nakujaproject/N-4_Solid_Propulsion/Grains/README.md

# Propellant Evaluation

## Overview
This directory shall contain all matters to do with the analysis, synthesis and improvement of the Grains.
