nakujaproject/N-4_Solid_Propulsion/Grains/Decatalysis/README.md

# Analysis of Burn Rate Modifiers on Propellant

## Overview

This directory contains the write up for the analysis of the Propellant used in the Static Test conducted on Friday, 31 January, 2025.
