nakujaproject/N-4_Solid_Propulsion/SRM Components/Design Calculations.pdf

CASING DESIGN

The casing houses the grains and has a bulkhead on the forward end and a nozzle on the rear. Combustion happens inside the casing and it is necessary to ensure it can withstand the high temperatures and pressures. Aluminium 6063 T5 was selected for the casing material as it has a higher strength-to-weight ratio than steel and is also available in tubular form from local vendors.

The wall thickness was designed based on the maximum expected operating pressure
(MEOP) Pc, of 5 MPa based on past data.

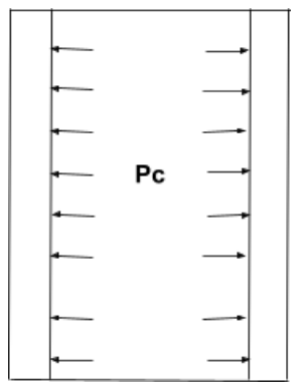
[picture p1: figure]

Figure 1: Casing design considerations
Problem Specifications | Al 6063 T5 Mechanical Properties
Specification | Value | Property | Value
Length, L Inner Diameter, d MEOP, Pc Minimum Sf | 725 mm
| 94 mm
| 4.26 MPa
| 2

σyp

σUTS

E

μ

110 MPa

150 MPa

70,000 MPa

0.33

Minimum thickness
Considering the hoop stress,

t =

Pc ∗ d ∗ Sf

2σyp

=

4.26 ∗ 94 ∗ 1.5
2 ∗ 110 = 2.7303 mm

A thickness of 3 mm is selected to cater for tolerances during manufacturing.

Expected change in length

∆l =

pc ∗ d ∗ l
4 ∗ t ∗ E

(1 − 2θ) =

5 ∗ 94 ∗ 725 4 ∗ 3 ∗ 70000 | (1 − 2 ∗ 0.33) = 0.1379 mm

Expected Change in diameter

∆d =

pc ∗ d

2
4 ∗ t ∗ E

(1 − θ) =

5 ∗ 94²
4 ∗ 3 ∗ 70000

(1 − 0.33) = 0.03524 mm

Burst Pressure

PB =

2 ∗ t ∗ σUTS
d

=

2 ∗ 3 ∗ 150
94 = 9.5745 MPa

NOZZLE DESIGN
Introduction
A de-Laval conical nozzle designed for the Nakuja N4 rocket was simulated in Ansys Fluent Software, and the throat and exit characteristics of the flow were determined. The nozzle accelerates the products of combustion, trading pressure for velocity to maximize the thrust generated.
Considerations for the expansion ratio, έ is the ratio of the nozzle exit area, Ae to that of the nozzle throat area, At.
Nozzle Design
The operating chamber pressure and Specific impulse were determined first using Open Motor,

Pc = 4. 26 MPa
Isp = 134. 83 s
Mass Flowrate,

ṁ =

I
Isp ∗ g

=

2431.36
134.22 ∗ 9.81 = 1. 8466 kg/s

Optimum throat area for sonic transition,

At =

ṁ

Pc ∗ √
R ∗ Tc
γ

∗ (1 +

γ − 1
2

)

γ+1
2γ−1

The specific gas constant of the combustion mixture is determined by,

R =

Ro
M

where M is the molecular weight = 35.361 g/mol (from Proprep)

Ro is the universal gas constant = 8.314 J/mol.

R =

8.314
35.361 ∗ 10⁻³ = 235. 1178

J
Kg.K

Chamber static temperature during combustion,

T c = 1595 K
Ratio of specific heats, γ = 1. 1369 (from Proprep)

Optimum throat diameter,

At =

1.8466
4.26 ∗ 10⁶

√
235.1178 ∗ 1595
1.1369 ∗ (1 +

1.1369 − 1
2

)

1.1369+1
2 (1.1369−1)
= 4. 17883 ∗ 10⁻⁴ m²

Throat diameter,

d = √
4 ∗ 4.17883 ∗ 10⁻⁴
π

= 23. 1 mm

Optimum throat-to-exit area ratio,

At
Ae

= (

γ + 1
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
∗ √(
γ + 1
γ − 1

) ∗ [1 − (
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
1.1369 + 1
2

)

1
1.1369−1
∗ (

101325
4.26 ∗ 10⁶

)

1
1.1369

∗ √(
1.1369 + 1
1.1369 − 1

) ∗ [1 − (
101325
4.26 ∗ 10⁶

)

1.1369−1
1.1369 ]

= 0. 14395

Optimum expansion ratio,

εopt = (

At
Ae

)

−1
= 0. 14395⁻¹ = 6. 947

Exit diameter,

De = √ε ∗ d = √6. 947 ∗ 23. 1 = 60. 9 mm ≅ 61 mm

BOLT DESIGN
a). BOLT SHEAR STRESS
This is the failure mode that occurs when the bolts used to hold the closure into the casing break due to the force applied perpendicular to the axis of the fastener. It is most likely to occur in designs with few fasteners of relatively small diameter, and is the only failure mode not affected by casing wall thickness.

Number of Bolts Calculation
Given Data:
- Maximum yield stress of mild steel: 250MPa
- Safety factor: 2
- Shear stress according to von Mises criterion is 60% of yield stress = 150MPa
- Diameter of M6 bolt: 6mm
- Chamber pressure (Pmax ):4. 26MPa
- Cross-sectional area of casing calculated based on inner diameter 94 mm
- Airframe weight: 22.5 Kg

Maximum Allowable Shear Stress,

τ max =

150MPa
2

= 75MPa

Shear stress on one bolt,

Area of M8 bolt =

π
4

∗ 8

2 = 50.2655 mm²

Force per bolt = τmax ∗ Area ∗ 2 = 75MPa ∗ 50.2655 ∗ 2 = 7539.82 N

Total Force Calculation
Force due to chamber pressure,

Fcℎamber = Pmax ∗ Cross − sectional Area = 4.26MPa ∗

π
4

∗ 94² = 29563.46 N

Force due to airframe resistance,

Fairframe = Weigℎt of airframe ∗ g = 22.5 kg ∗ 9.81 = 220.725 N
Total force,

Ftotal = Fcℎamber + Fairframe = 29563.46 + 220.725 = 29784.19 N
Number of bolts required,

Number of bolts =

Ftotal
Force per bolt =

29784.19
7539.82 = 3.95 ≈ 4 bolts

b). BOLT TEAR-OUT STRESS
Bolt tear-out is the failure in which the bolts tear through the aluminum motor casing. It is most likely to occur in designs where the fastener holes are very close to the edge of the casing, or the casing wall is relatively thin. This type of failure results from shear stresses in the
aluminum casing wall.

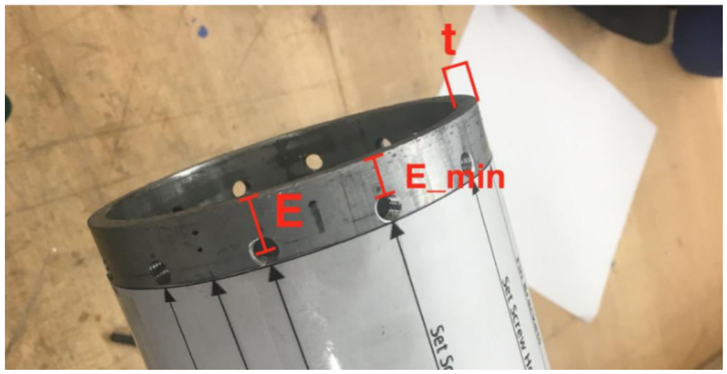
[picture p2: figure]

Note that E >= 2d (bolt major diameter) is highly recommended. And so E >= 2*8 mm = 16 mm

E(min) = E −

d(bolt,major)
2

= 16 −

8
2

= 12 mm

σtearout =

Fbolt
Emin ∗ 2t

=

7539.82
12 ∗ 2 ∗ 3

= 104.72 MPa

Shear strength is given as 115Mpa for aluminium 6063-T5.

c). BEARING STRESS
Bearing failure occurs when the force of the bolts pushing against the edges of their holes causes the casing material to fail in compression.
Bearing yield strength is given as 276MPa (not true value) for Aluminium 6063-T5.

σbearing =

Fbolt

dbolt major ∗ t

=

7539.82
8 ∗ 3

= 314.159 MPa

Using a safety factor of 1.5, maximum allowable bearing pressure = 184MPa

σbearing =

Fbolt

dbolt major ∗ t

=> Fbolt = 184 ∗ 8 ∗ 3 = 4416 N

Number of bolts =

Ftotal
Force per bolt =

29784.19 N
4416 N

= 6.745 ≅ 7 bolts.

To prevent bearing failure, 8 bolts are selected to ensure symmetry.

d). CASING TENSILE FAILURE
Casing tensile failure occurs when portions of the aluminium casing between the fastener holes are stretched beyond its breaking point.

σtensile =

Fdue to cℎamber pressure

[(Douter casing − t)π − N ∗ dbolt major] ∗ t

=

29563.46 N
[(100 − 3) ∗ π − 8 ∗ 8] ∗ 3

= 40.935 MPa
Aluminum 6063-T5 has a yield strength of at least 110 MPa
