nakujaproject/N-4_Solid_Propulsion/Ignition System/Alarm system module/3D view.png

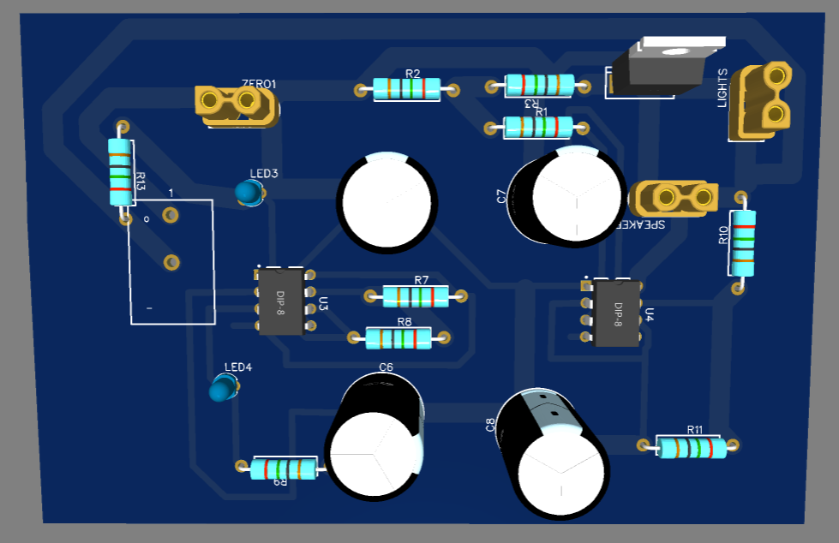
Ignition System/Alarm system module/3D view.png
