nakujaproject/N-4_Solid_Propulsion/Ignition System/Igniter circuit module/3D view.png

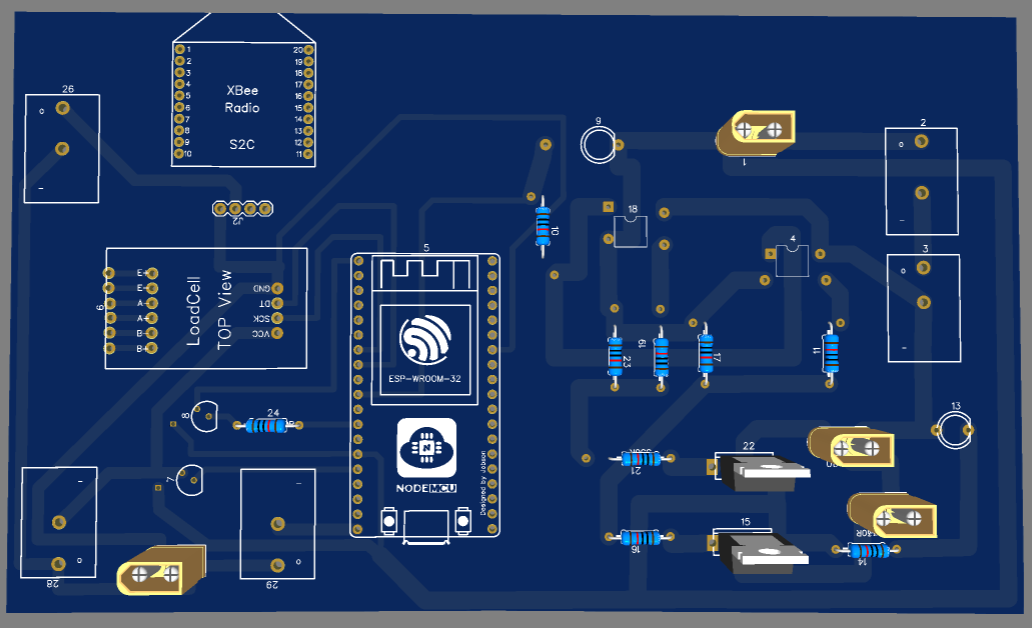
Ignition System/Igniter circuit module/3D view.png
