nakujaproject/N-4_Solid_Propulsion/Ignition System/Power Distribution Board module/3D view.png

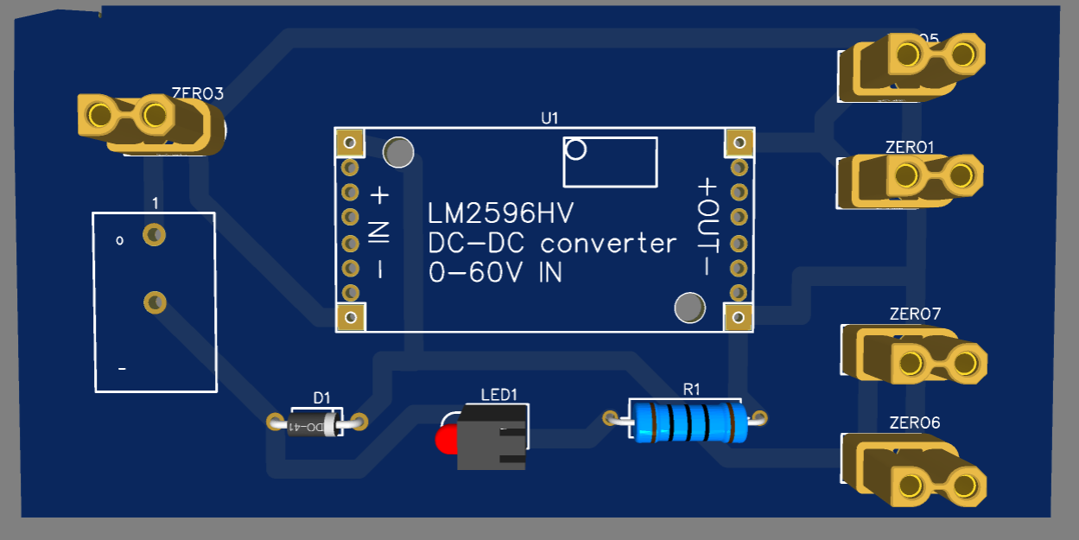
Ignition System/Power Distribution Board module/3D view.png
