nakujaproject/N-4_Solid_Propulsion/Ignition System/Trigger Module/3D view.png

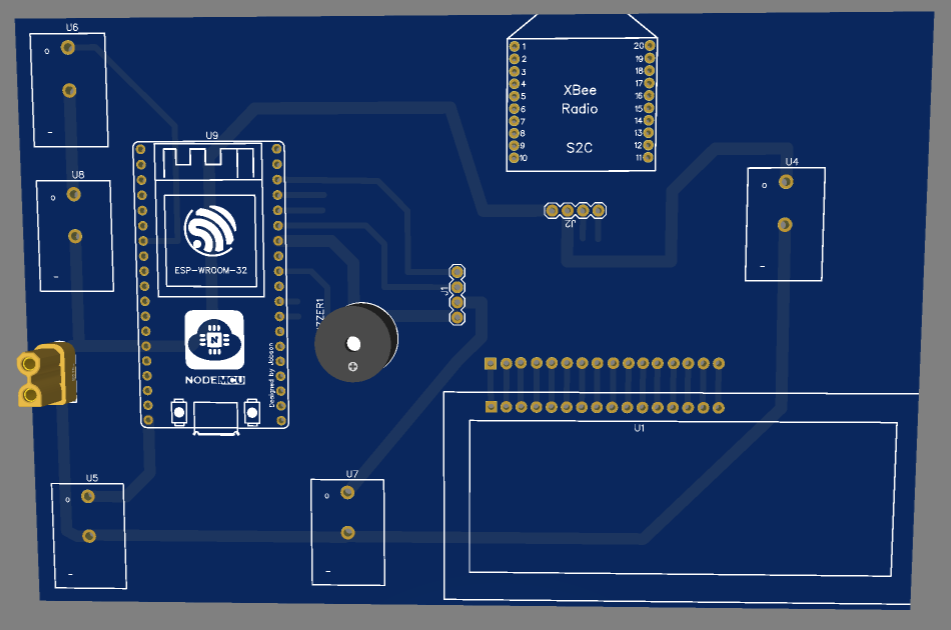
Ignition System/Trigger Module/3D view.png
