nakujaproject/N-4_Solid_Propulsion/SRM Components/README.md

# Solid Rocket Motor(SRM) Components

## Overview

This directory contains the design files and other necessary write ups for the SRM Components.
