nakujaproject/N-4_Solid_Propulsion/Static Test/Test #4/3_grain_Motor.SLDASM

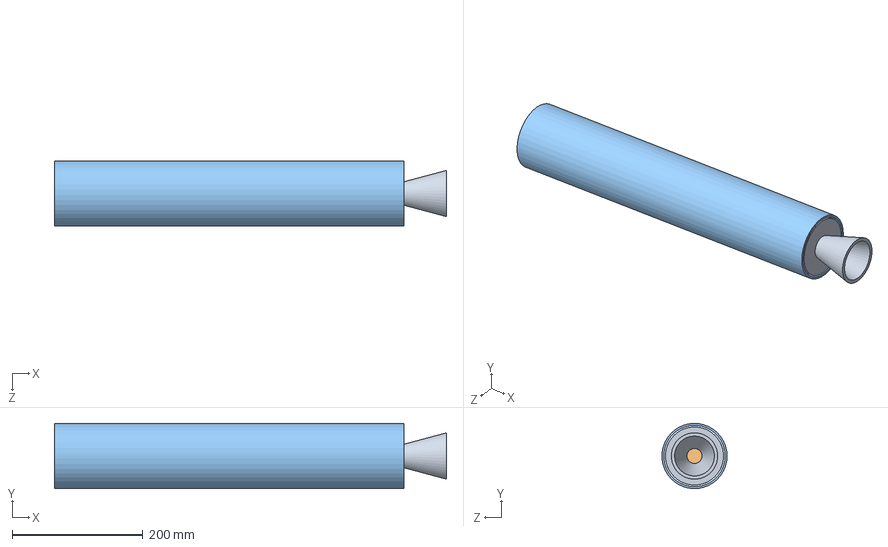
[picture p8: CAD file, 2025-02-07]
Static Test/Test #4/3_grain_Motor.SLDASM
600.2 x 99.9 x 100.0 mm
3_grain_Casing
Bulkhead
Nozzle2
