nakujaproject/N-4_Solid_Propulsion/Static Test/Test #1/Motor_Assembly_Test#1.SLDASM

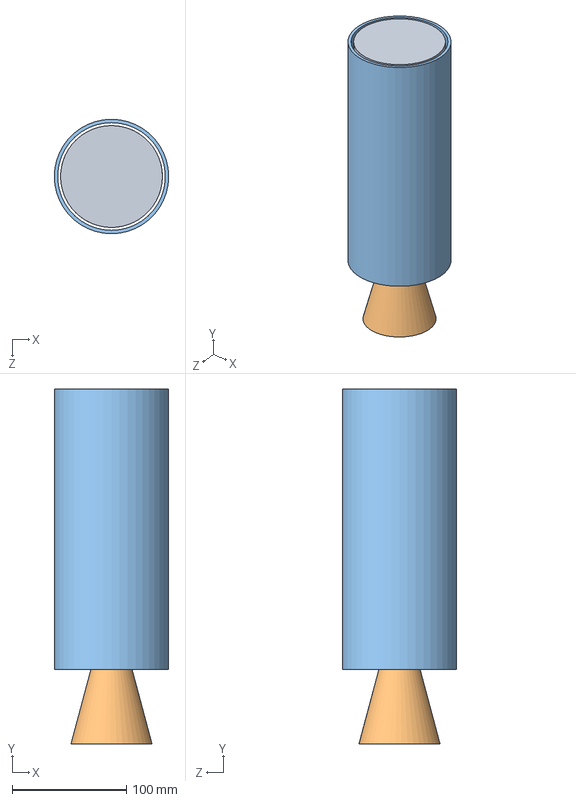
[picture p9: CAD file, 2025-02-07]
Static Test/Test #1/Motor_Assembly_Test#1.SLDASM
100.0 x 310.2 x 100.0 mm
Casing_Test#1
Nozzle2
Bulkhead
