nakujaproject/N-4_Solid_Propulsion/SRM Components/Assem1.SLDASM

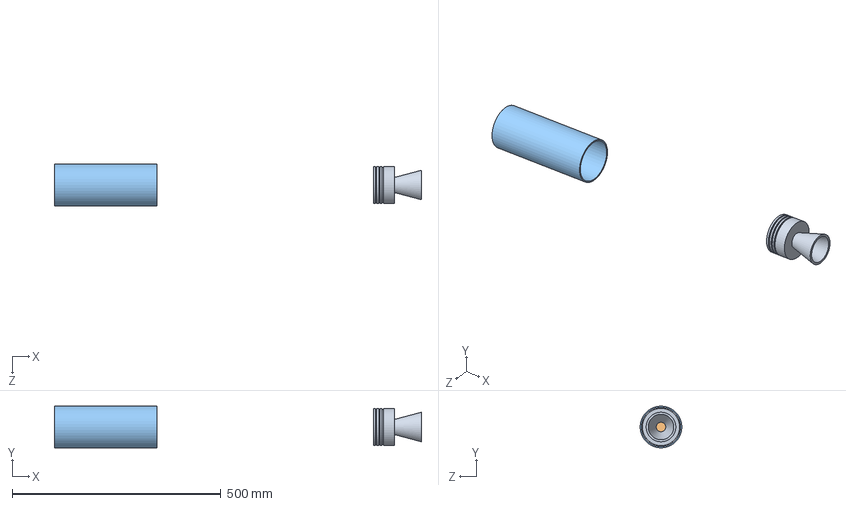
[picture p10: CAD file, 2025-02-07]
SRM Components/Assem1.SLDASM
878.8 x 100.0 x 100.0 mm
Casing
Bulkhead
Nozzle2
