nakujaproject/N-4_Solid_Propulsion/SRM Components/BodyTubeJig 1X15mm.SLDPRT

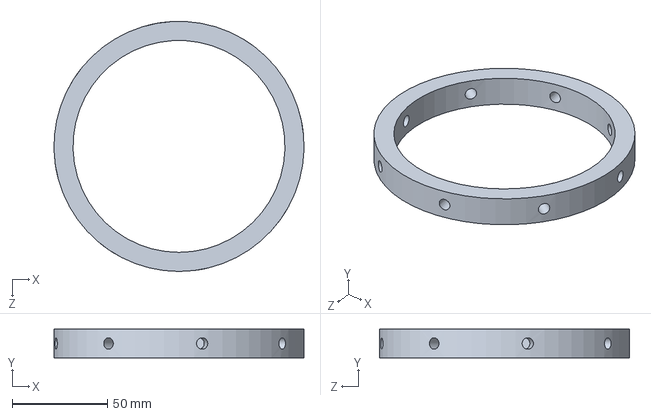
[picture p11: CAD file, 2025-02-07]
SRM Components/BodyTubeJig 1X15mm.SLDPRT
130.9 x 15.0 x 130.9 mm
