nakujaproject/N-4_Solid_Propulsion/Static Test/Test #1/Casing_Test#1.SLDPRT

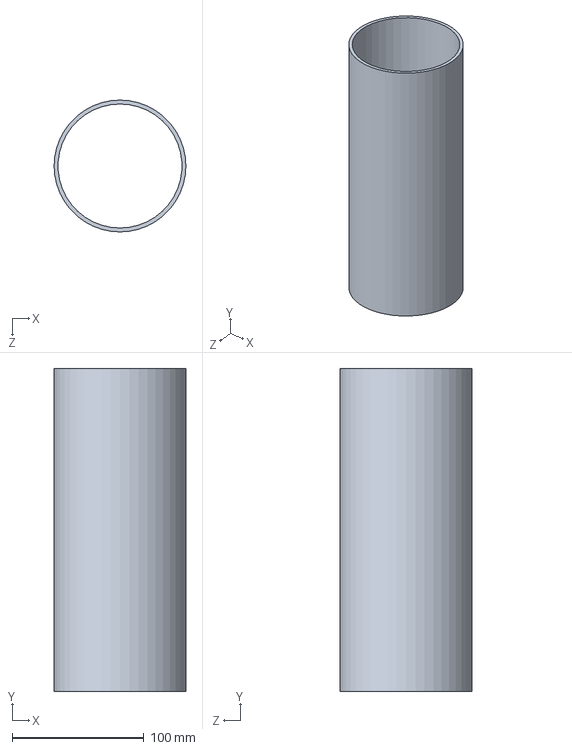
[picture p12: CAD file, 2025-02-07]
Static Test/Test #1/Casing_Test#1.SLDPRT
100.0 x 245.0 x 100.0 mm
