nakujaproject/N-4_Solid_Propulsion/Test Stand/TestStand_Design#2.STEP

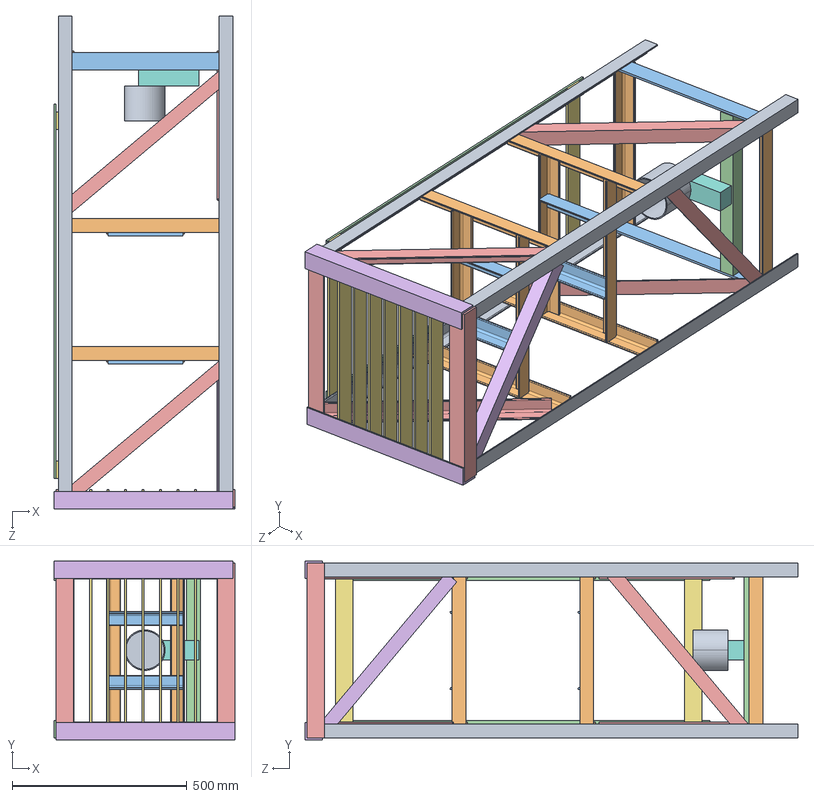
[picture p13: CAD file, 2025-02-07]
Test Stand/TestStand_Design#2.STEP
518.0 x 512.0 x 1412.0 mm
equal angle (new zealand) as-nzs_AS-NZS 3679.1 EAN - 40x40x5x1400 x 4
equal angle (new zealand) as-nzs_AS-NZS 3679.1 EAN - 40x40x5x490 x 6
bottom_flat-50x6x476 x 2
equal angle (new zealand) as-nzs_AS-NZS 3679.1 EAN - 40x40x5x476
equal angle (new zealand) as-nzs_AS-NZS 3679.1 EAN - 50x50x6x500 x 2
equal angle (new zealand) as-nzs_AS-NZS 3679.1 EAN - 50x50x6x512 x 2
top_flat-50x6x500 x 7
LoadCell
Motor Holder
equal angle (new zealand) as-nzs_AS-NZS 3679.1 EAN - 40x40x5x480 x 4
equal angle (new zealand) as-nzs_AS-NZS 3679.1 EAN - 40x40x5x214 x 4
Door_straight-50x6x1073^TestStand_Design#2 x 2
Door_horizontal-50x6x500^TestStand_Design#2 x 2
equal angle (new zealand) as-nzs_AS-NZS 3679.1 EAN - 40x40x5x598 x 5
equal angle (new zealand) as-nzs_AS-NZS 3679.1 EAN - 40x40x5x580
