nakujaproject/N-4_Solid_Propulsion/Static Test/Test #1/Nozzle2.SLDPRT

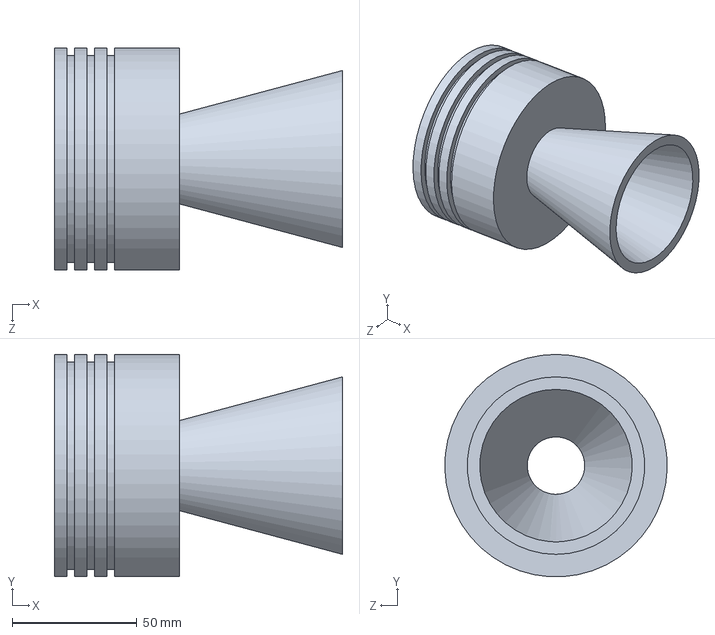
[picture p14: CAD file, 2025-02-07]
Static Test/Test #1/Nozzle2.SLDPRT
115.2 x 88.9 x 88.9 mm
