nakujaproject/N-4_Solid_Propulsion/Static Test/Test #4/Bulkhead.SLDPRT

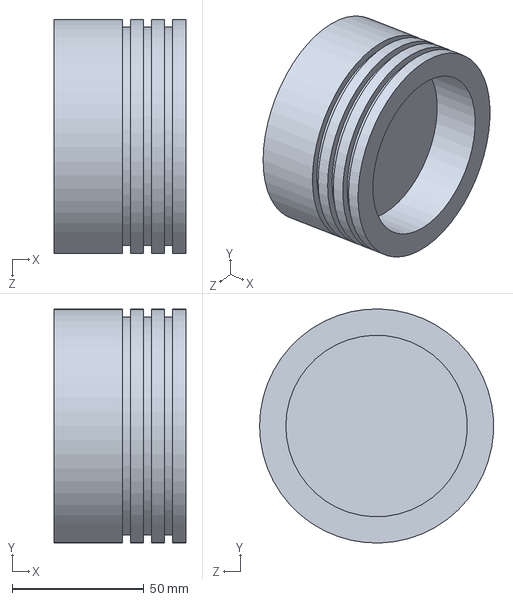
[picture p15: CAD file, 2025-02-07]
Static Test/Test #4/Bulkhead.SLDPRT
50.0 x 89.0 x 88.9 mm
