nakujaproject/N-4_Solid_Propulsion/SRM Components/Bulkhead.SLDPRT

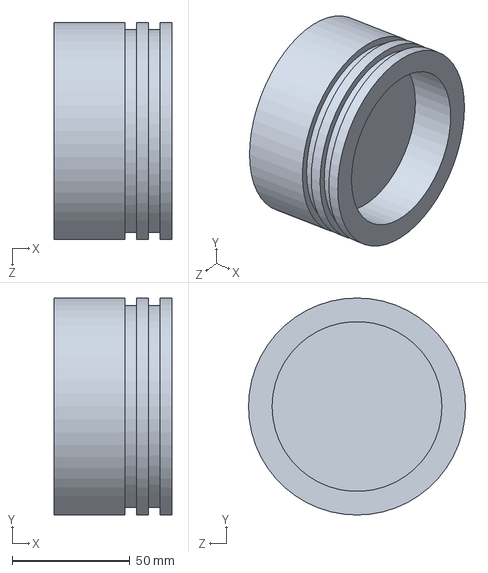
[picture p16: CAD file, 2025-02-07]
SRM Components/Bulkhead.SLDPRT
50.0 x 92.0 x 92.0 mm
