nakujaproject/N-4_Solid_Propulsion/Static Test/Test #4/3_grain_Casing.SLDPRT

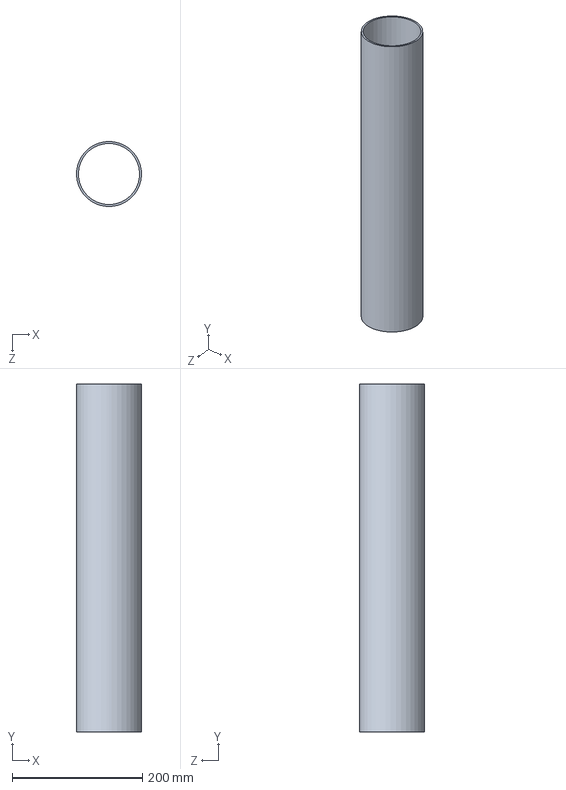
[picture p17: CAD file, 2025-02-07]
Static Test/Test #4/3_grain_Casing.SLDPRT
99.9 x 535.0 x 100.0 mm
