nakujaproject/N-4_Solid_Propulsion/SRM Components/Nozzle2.SLDPRT

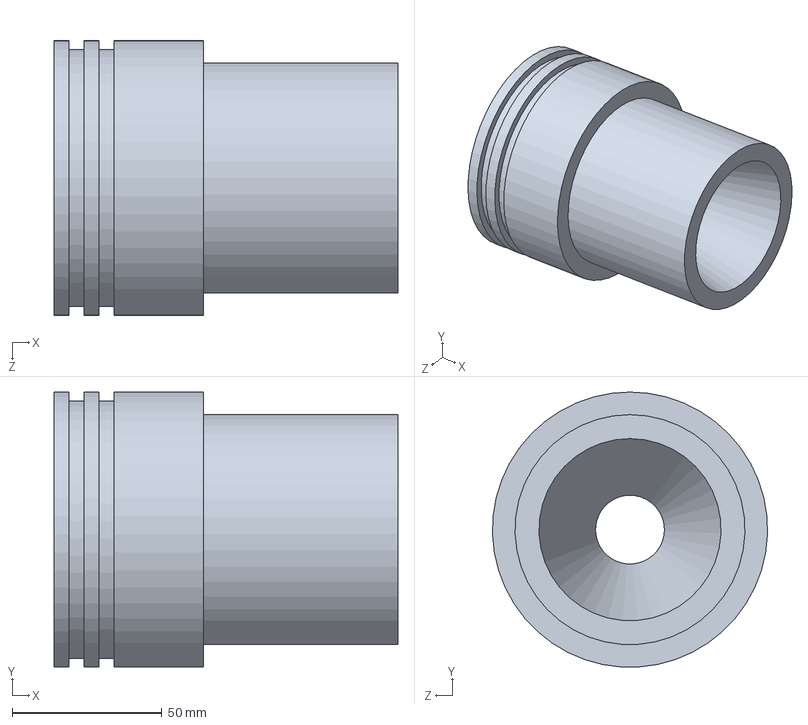
[picture p18: CAD file, 2025-02-07]
SRM Components/Nozzle2.SLDPRT
115.0 x 91.9 x 91.9 mm
