nakujaproject/N-4_Solid_Propulsion/(list of files, cad)

Other CAD files:
SRM Components/Casing.SLDPRT
Static Test/Test #1/Bulkhead.SLDPRT
Static Test/Test #4/Nozzle2.SLDPRT
SRM Components/Bulkhead_Drawing.SLDDRW
SRM Components/Casing_drawings.SLDDRW
SRM Components/Nozzle2_Drawing.SLDDRW
Test Stand/TestStand_Design#2.SLDASM
