nakujaproject/N-4_Solid_Propulsion/Static Test/Test #5/static test jan.txt

Broadcast message success
button is pressedLast Packet Sent to: ff:ff:ff:ff:ff:ff
Last Packet Send Status: Delivery Success
441746, 39.46,26.75,0.00
442293, -28.94,26.75,0.00
442840, 213048.92,26.75,0.00
443387, 325880.91,26.75,0.00
443934, -6221.68,26.75,0.00
