nakujaproject/N-4_Solid_Propulsion/Static Test/Test #4/Static test 31st Oct 2024 (reducted).txt

Broadcast message success
button is pressedLast Packet Sent to: ff:ff:ff:ff:ff:ff
Last Packet Send Status: Delivery Success
16251, 213.08
16261, 213.78
16272, 212.21
16282, 210.80
16293, 211.33
16304, 211.15
16315, 210.28
16325, 209.58
16336, 208.35
16347, 206.24
16357, 207.12
16368, 208.00
16379, 207.12
16389, 206.94
16400, 208.52
16411, 210.28
16422, 211.86
16432, 211.33
16443, 208.87
16454, 208.87
16464, 210.80
16475, 212.91
16486, 210.98
16496, 210.10
16507, 211.86
16518, 213.96
16529, 212.38
16539, 212.56
16550, 212.03
16561, 211.86
16571, 212.91
16582, 214.84
16593, 216.06
16603, 216.06
16614, 216.59
16625, 218.52
16635, 220.10
16646, 220.62
16657, 219.40
16668, 217.82
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
