nakujaproject/N-4_Solid_Propulsion/Static Test/Test #4/Static test 31st Oct 2024.txt

ets Jul 29 2019 12:21:46

rst:0x1 (POWERON_RESET),boot:0x13 (SPI_FAST_FLASH_BOOT)
configsip: 0, SPIWP:0xee
clk_drv:0x00,q_drv:0x00,d_drv:0x00,cs0_drv:0x00,hd_drv:0x00,wp_drv:0x00
mode:DIO, clock div:1
load:0x3fff0030,len:1448
load:0x40078000,len:14844
ho 0 tail 12 room 4
load:0x40080400,len:4
load:0x40080404,len:3356
entry 0x4008059c
ESP-NOW Broadcast Demo
MAC Address: 00:00:00:00:00:00
ESP-NOW Init Success
116, 227.11
127, 230.09
137, 229.39
148, 228.69
159, 229.04
169, 229.92
180, 232.55
191, 231.50
201, 228.69
212, 225.89
223, 224.48
234, 223.08
244, 222.55
255, 220.80
266, 219.57
276, 218.87
287, 217.29
298, 216.94
308, 214.49
319, 211.33
330, 211.15
340, 212.21
351, 211.50
362, 210.63
373, 208.52
383, 208.52
394, 208.87
405, 210.28
415, 211.86
426, 214.31
437, 215.54
447, 215.19
458, 215.19
469, 215.89
479, 215.89
490, 215.71
501, 217.64
512, 219.57
522, 220.27
533, 219.92
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
ets Jul 29 2019 12:21:46

rst:0x8 (TG1WDT_SYS_RESET),boot:0x13 (SPI_FAST_FLASH_BOOT)
configsip: 0, SPIWP:0xee
clk_drv:0x00,q_drv:0x00,d_drv:0x00,cs0_drv:0x00,hd_drv:0x00,wp_drv:0x00
mode:DIO, clock div:1
load:0x3fff0030,len:1448
load:0x40078000,len:14844
ho 0 tail 12 room 4
load:0x40080400,len:4
load:0x40080404,len:3356
entry 0x4008059c
ESP-NOW Broadcast Demo
MAC Address: 00:00:00:00:00:00
ESP-NOW Init Success
117, 130.83
128, 131.71
139, 132.59
149, 131.71
160, 129.60
171, 128.03
181, 127.50
192, 127.32
203, 127.67
213, 127.32
224, 126.62
235, 125.75
245, 125.39
256, 125.57
267, 125.92
277, 125.39
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
16454, 208.87
16464, 210.80
16475, 212.91
16486, 210.98
16496, 210.10
16507, 211.86
16518, 213.96
16529, 212.38
16539, 212.56
16550, 212.03
16561, 211.86
16571, 212.91
16582, 214.84
16593, 216.06
16603, 216.06
16614, 216.59
16625, 218.52
16635, 220.10
16646, 220.62
16657, 219.40
16668, 217.82
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
