nakujaproject/N-4_Solid_Propulsion/Static Test/Test #1/Static Test #1.txt

; Nakuja Project Static Test #1
; Carried out on Friday 14th June 2024
; created by Ogweno Emmanuel 6/21.2024
N4_1 86 145 P 1.191 3.3 Nakuja 
0	0
0	10.08738213
0.011	10.52075346
0.022	10.96795266
0.032	11.45300688
0.043	11.94316074
0.054	12.43507986
0.064	12.93896352
0.075	13.53581754
0.086	14.08442112
0.097	14.70706755
0.107	15.40532595
0.129	16.9739556
0.139	17.87345364
0.15	18.92770614
0.161	19.94420169
0.177	20.94010254
0.182	21.9117801
0.193	23.10029043
0.204	24.47454534
0.214	25.51850049
0.225	26.70181311
0.236	28.08116766
0.246	29.47944972
0.257	30.87606459
0.268	32.30533677
0.28	33.8567061
0.289	35.40631017
0.3	36.87343737
0.311	38.72578353
0.321	40.64697483
0.332	42.57669822
0.343	44.52711438
0.353	46.68730227
0.364	48.91800249
0.375	50.95275885
0.385	52.90994184
0.396	54.93606804
0.407	57.7102722
0.418	60.38817162
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
