nakujaproject/N-4_Solid_Propulsion/Static Test/Test #4/Static test 25th april 2024 analysis..xlsx

Sheet: SIMULATED VS ACTUAL 25_04_2024
SIMULATED TIME | SIMULATED THRUST | ACTUAL TIME (ms) | ACTUAL TIME (s) | ACTUAL THRUST (gf) | ACTUAL THRUST (N) | IMPULSE
0 | 0 | 134956 | 0 | -14.91 | -0.1462671 | -0.0029286774
0.03 | 1113.17484 | 134979 | 0.023 | -11.05 | -0.1084005 | -0.0009938511
0.06 | 1140.93601 | 134990 | 0.034 | -7.37 | -0.0722997 | -0.0009938511
0.09 | 1168.54542 | 135023 | 0.067 | 1.23 | 0.0120663 | 0.09842063985
0.12 | 1195.95482 | 135192 | 0.236 | 117.5 | 1.152675 | 0.0284817654
0.15 | 1223.1147 | 135214 | 0.258 | 146.44 | 1.4365764 | 0.01583093655
0.18 | 1249.97442 | 135225 | 0.269 | 146.97 | 1.4417757 | 0.03456538785
0.21 | 1273.35386 | 135248 | 0.292 | 159.42 | 1.5639102 | 0.0174868155
0.24 | 1286.42713 | 135259 | 0.303 | 164.68 | 1.6155108 | 0.0357117354
0.27 | 1299.04592 | 135281 | 0.325 | 166.26 | 1.6310106 | 0.0196339302
0.3 | 1311.20843 | 135293 | 0.337 | 167.31 | 1.6413111 | 0.01828157265
0.33 | 1322.91293 | 135304 | 0.348 | 171.52 | 1.6826112 | 0.05876185095
0.36 | 1334.15776 | 135337 | 0.381 | 191.51 | 1.8787131 | 0.04993755975
0.39 | 1344.94134 | 135360 | 0.404 | 251.14 | 2.4636834 | 0.033354981
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
