nakujaproject/N-4_Solid_Propulsion/Static Test/Test #4/Static test on 31st Oct 2024 (Analysis).xlsx

Simulated Time (s) | Simulated Thrust (N) | Actual Time (ms) | Time Diff (ms) | Actual Time (s) | Actual Thrust (g) | Actual Thrust (N) | Actual Impulse (Ns)
0 | 0 | 29883 | 0 | 0 | 215.01 | 2.1092481 | 14.54356711
0.03 | 1173.3067 | 30247 | 364 | 0.364 | 7930.73 | 77.8004613 | 0.9038838353
0.06 | 1180.11471 | 30258 | 375 | 0.375 | 8821.82 | 86.5420542 | 0.91469421
0.09 | 1186.80055 | 30268 | 385 | 0.385 | 9826.38 | 96.3967878 | 1.121728766
0.12 | 1193.3643 | 30279 | 396 | 0.396 | 10963.7 | 107.553897 | 1.252528096
0.15 | 1199.806 | 30290 | 407 | 0.407 | 12250.61 | 120.1784841 | 2.828572923
0.18 | 1206.12571 | 30311 | 428 | 0.428 | 15209.93 | 149.2094133 | 1.732701158
0.21 | 1212.32349 | 30322 | 439 | 0.439 | 16903.89 | 165.8271609 | 1.748173883
0.24 | 1218.39939 | 30332 | 449 | 0.449 | 18736.76 | 183.8076156 | 12.73670834
0.27 | 1224.35346 | 30386 | 503 | 0.503 | 29349.88 | 287.9223228 | 3.290091191
0.3 | 1230.18575 | 30397 | 514 | 0.514 | 31628.55 | 310.2760755 | 117.5080245
0.33 | 1235.8963 | 30643 | 760 | 0.76 | 65756.75 | 645.0737175 | 6.491968115
0.36 | 1241.48517 | 30653 | 770 | 0.77 | 66597.34 | 653.3199054 | 7.237473522
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
