nakujaproject/N-4_Solid_Propulsion/Static Test/Test #3/static test 13th aug 2024.csv

Simulated Time(s) | Simulated Thrust(N) | Actual Time (ms) | Time diff (ms) | Actual Time (s) | Actual Thrust (g) | Actual Thrust (N) | Actual Impulse (Ns)
0 | 0 | 140264 | 0 | 0 | 690.11 | 6.7699791 | 0.0829952
0.03 | 1173.3067 | 140275 | 11 | 0.011 | 848.12 | 8.3200572 | 0.102279796
0.06 | 1180.11471 | 140286 | 22 | 0.022 | 1047.53 | 10.2762693 | 0.11445278
0.09 | 1186.80055 | 140296 | 32 | 0.032 | 1285.86 | 12.6142866 | 0.153982714
0.12 | 1193.3643 | 140307 | 43 | 0.043 | 1568.05 | 15.3825705 | 0.186921702
0.15 | 1199.806 | 140318 | 54 | 0.054 | 1896.35 | 18.6031935 | 0.225386222
0.18 | 1206.12571 | 140329 | 65 | 0.065 | 2280.95 | 22.3761195 | 0.270569757
0.21 | 1212.32349 | 140340 | 76 | 0.076 | 2733.78 | 26.8183818 | 0.294816006
0.24 | 1218.39939 | 140350 | 86 | 0.086 | 3276.74 | 32.1448194 | 0.388443627
0.27 | 1224.35346 | 140361 | 97 | 0.097 | 3922.66 | 38.4812946 | 0.465298208
0.3 | 1230.18575 | 140372 | 108 | 0.108 | 4701.16 | 46.1183796 | 0.558143972
0.33 | 1235.8963 | 140383 | 119 | 0.119 | 5643.46 | 55.3623426 | 0.609228468
0.36 | 1241.48517 | 140393 | 129 | 0.129 | 6777.1 | 66.483351 | 0.800553536
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
