nakujaproject/N-4_Solid_Propulsion/Static Test/Test #2/Test Data Analysis.xlsx

Sheet: Static test II 26-07-24
245056 | 0 | 2366.01
245067 | 11 | 2461.24
245079 | 23 | 2562.26
245090 | 34 | 2670.29
245101 | 45 | 2772.19
245112 | 56 | 2867.77
245123 | 67 | 2967.2
245134 | 78 | 3079.09
245145 | 89 | 3187.48
245156 | 100 | 3291.13
245167 | 111 | 3407.75
245178 | 122 | 3541.92
245189 | 133 | 3684.85
245200 | 144 | 3846.9
245211 | 155 | 4026.48
245222 | 166 | 4211.86
245233 | 177 | 4423.36
245244 | 188 | 4664.5
245255 | 199 | 4921.96
245266 | 210 | 5208.17
245277 | 221 | 5549.28
245288 | 232 | 5918.63
245299 | 243 | 6356.89
245310 | 254 | 6678.53
245321 | 265 | 6678.53
245332 | 276 | 6727.64
245344 | 288 | 7203.96
245355 | 299 | 8351.46
245366 | 310 | 10481.41
245377 | 321 | 11248.86
245388 | 332 | 11754.65
245399 | 343 | 12988.78
245410 | 354 | 14346.72
245421 | 365 | 15002.98
245432 | 376 | 15545.77
245443 | 387 | 16635.57
245454 | 398 | 17671.69
245465 | 409 | 18208.52
245476 | 420 | 18928.62
245487 | 431 | 19935.11
245498 | 442 | 20653.8
245509 | 453 | 21439.67
245520 | 464 | 22850.58
245531 | 475 | 23829.53
245542 | 486 | 24199.93
245553 | 497 | 23625.39
245564 | 508 | 23522.8
245575 | 519 | 24262.89
245586 | 530 | 25136.44
245597 | 541 | 25544.02
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
