nakujaproject/N-4_Solid_Propulsion/Static Test/Test #1/N4_1grain_simulated.csv

Time(s) | Thrust(N)
0 | 0
0.03 | 311.60302
0.06 | 314.06578
0.09 | 316.46953
0.12 | 318.81477
0.15 | 321.10201
0.18 | 323.33174
0.21 | 325.50442
0.24 | 327.62049
0.27 | 329.6804
0.3 | 331.68454
0.33 | 333.63334
0.36 | 335.52716
0.39 | 337.36638
0.42 | 339.15136
0.45 | 340.88244
0.48 | 342.55995
0.51 | 344.1842
0.54 | 345.7555
0.57 | 347.27415
0.6 | 348.74041
0.63 | 350.15455
0.66 | 351.51684
0.69 | 352.82752
0.72 | 354.08683
0.75 | 355.29498
0.78 | 356.45219
0.81 | 357.55867
0.84 | 358.6146
0.87 | 359.62018
0.9 | 360.57557
0.93 | 361.48094
0.96 | 362.33645
0.99 | 363.14224
1.02 | 363.89844
1.05 | 364.6052
1.08 | 365.26262
1.11 | 365.87082
1.14 | 366.4299
1.17 | 366.93996
1.2 | 367.40107
1.23 | 367.81333
1.26 | 368.17679
1.29 | 368.49152
1.32 | 368.75758
1.35 | 368.975
1.38 | 369.14382
1.41 | 369.26408
1.44 | 369.33579
1.47 | 369.35897
1.5 | 369.33362
1.53 | 369.25975
1.56 | 369.13733
1.59 | 368.96636
1.62 | 368.7468
1.65 | 368.47863
1.68 | 368.1618
1.71 | 367.79625
1.74 | 367.38194
1.77 | 366.9188
1.8 | 366.40674
1.83 | 365.8457
1.86 | 365.23557
1.89 | 364.57626
1.92 | 363.86767
1.95 | 363.10966
1.98 | 362.30213
2.01 | 361.44494
2.04 | 360.53794
2.07 | 359.58098
2.1 | 358.5739
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
