nakujaproject/N-4_Solid_Propulsion/Static Test/Test #1/StaticTest1.xlsx

Sheet: Raw Data
Initial Value | t(ms) |  | M [grams] | W into N | t(s)
75318 | 0 | 75318 | 1028.59 | 10.08738213 | 0
75318 | 11 | 75329 | 1072.78 | 10.52075346 | 0.011
75318 | 22 | 75340 | 1118.38 | 10.96795266 | 0.022
75318 | 32 | 75350 | 1167.84 | 11.45300688 | 0.032
75318 | 43 | 75361 | 1217.82 | 11.94316074 | 0.043
75318 | 54 | 75372 | 1267.98 | 12.43507986 | 0.054
75318 | 64 | 75382 | 1319.36 | 12.93896352 | 0.064
75318 | 75 | 75393 | 1380.22 | 13.53581754 | 0.075
75318 | 86 | 75404 | 1436.16 | 14.08442112 | 0.086
75318 | 97 | 75415 | 1499.65 | 14.70706755 | 0.097
75318 | 107 | 75425 | 1570.85 | 15.40532595 | 0.107
75318 | 129 | 75447 | 1730.8 | 16.9739556 | 0.129
75318 | 139 | 75457 | 1822.52 | 17.87345364 | 0.139
75318 | 150 | 75468 | 1930.02 | 18.92770614 | 0.15
75318 | 161 | 75479 | 2033.67 | 19.94420169 | 0.161
75318 | 177 | 75495 | 2135.22 | 20.94010254 | 0.177
75318 | 182 | 75500 | 2234.3 | 21.9117801 | 0.182
75318 | 193 | 75511 | 2355.49 | 23.10029043 | 0.193
75318 | 204 | 75522 | 2495.62 | 24.47454534 | 0.204
75318 | 214 | 75532 | 2602.07 | 25.51850049 | 0.214
75318 | 225 | 75543 | 2722.73 | 26.70181311 | 0.225
75318 | 236 | 75554 | 2863.38 | 28.08116766 | 0.236
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
