nakujaproject/N-4_Solid_Propulsion/Static Test/Test #4/Simulated.csv

Time(s) | Thrust(N)
0 | 0
0.03 | 1173.3067
0.06 | 1180.11471
0.09 | 1186.80055
0.12 | 1193.3643
0.15 | 1199.806
0.18 | 1206.12571
0.21 | 1212.32349
0.24 | 1218.39939
0.27 | 1224.35346
0.3 | 1230.18575
0.33 | 1235.8963
0.36 | 1241.48517
0.39 | 1246.9524
0.42 | 1252.29804
0.45 | 1257.52212
0.48 | 1262.6247
0.51 | 1267.6058
0.54 | 1272.46548
0.57 | 1277.20376
0.6 | 1281.82069
0.63 | 1286.31631
0.66 | 1290.69065
0.69 | 1294.94373
0.72 | 1299.07561
0.75 | 1303.0863
0.78 | 1306.97584
0.81 | 1310.74426
0.84 | 1314.39158
0.87 | 1317.91784
0.9 | 1321.32306
0.93 | 1324.60727
0.96 | 1327.77049
0.99 | 1330.81275
1.02 | 1333.73407
1.05 | 1336.53447
1.08 | 1339.21396
1.11 | 1341.77258
1.14 | 1344.21035
1.17 | 1346.52727
1.2 | 1348.72336
1.23 | 1350.79865
1.26 | 1352.75314
1.29 | 1354.58686
1.32 | 1356.29981
1.35 | 1357.89201
1.38 | 1359.36347
1.41 | 1360.7142
1.44 | 1361.94421
1.47 | 1363.05351
1.5 | 1364.0421
1.53 | 1364.91
1.56 | 1365.65721
1.59 | 1366.28374
1.62 | 1366.78959
1.65 | 1367.17477
1.68 | 1367.43927
1.71 | 1367.5831
1.74 | 1367.60627
1.77 | 1367.50877
1.8 | 1367.29059
1.83 | 1366.95175
1.86 | 1366.49224
1.89 | 1365.91205
1.92 | 1365.21118
1.95 | 1364.38962
1.98 | 1363.44738
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
