nakujaproject/N-4_Solid_Propulsion/Grains/Decatalysis/ProPEP Simulations/TestingKNSB_FeO3 Catalyst.JPG

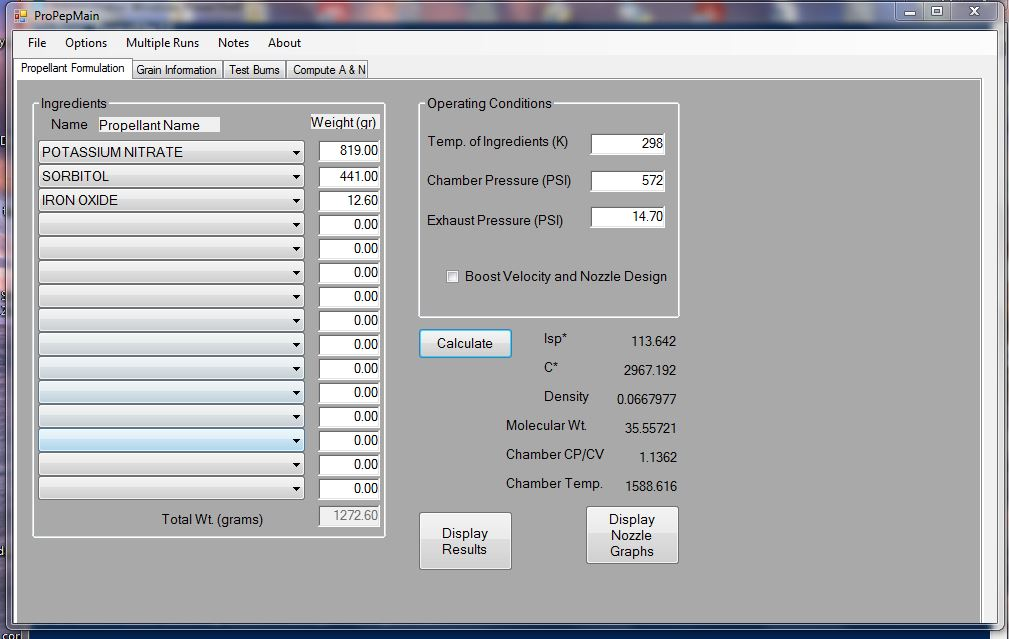
Grains/Decatalysis/ProPEP Simulations/TestingKNSB_FeO3 Catalyst.JPG
