nakujaproject/N-4_Solid_Propulsion/Grains/Decatalysis/ProPEP Simulations/TestingKNSB_OxFe Proposed.JPG

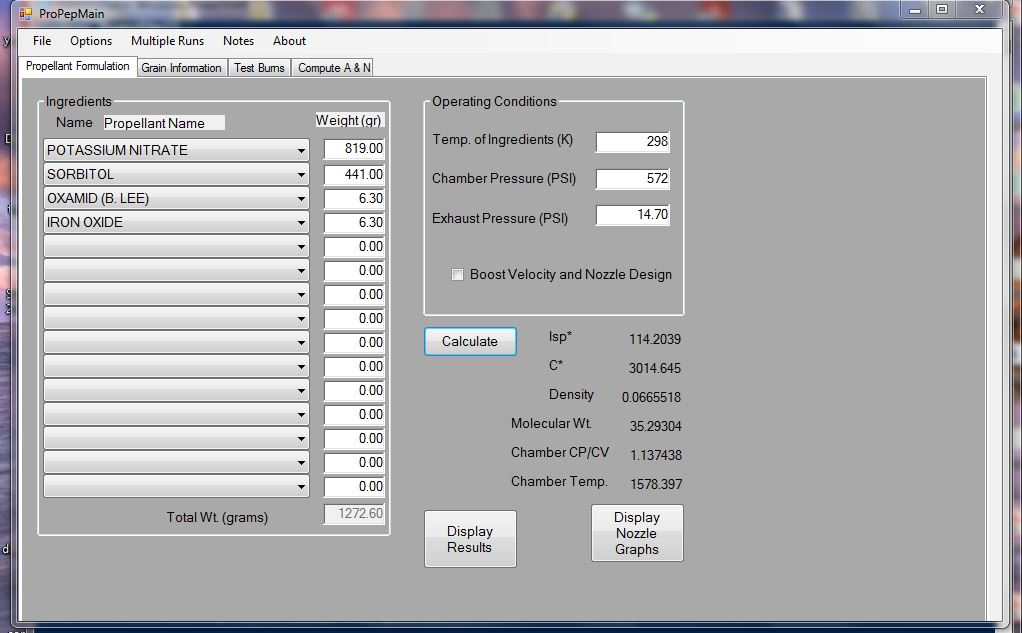
Grains/Decatalysis/ProPEP Simulations/TestingKNSB_OxFe Proposed.JPG
