nakujaproject/N-4_Solid_Propulsion/Static Test/Test #3/475f5efb-72d6-4bed-bb2a-de2ddac30baa.jpg

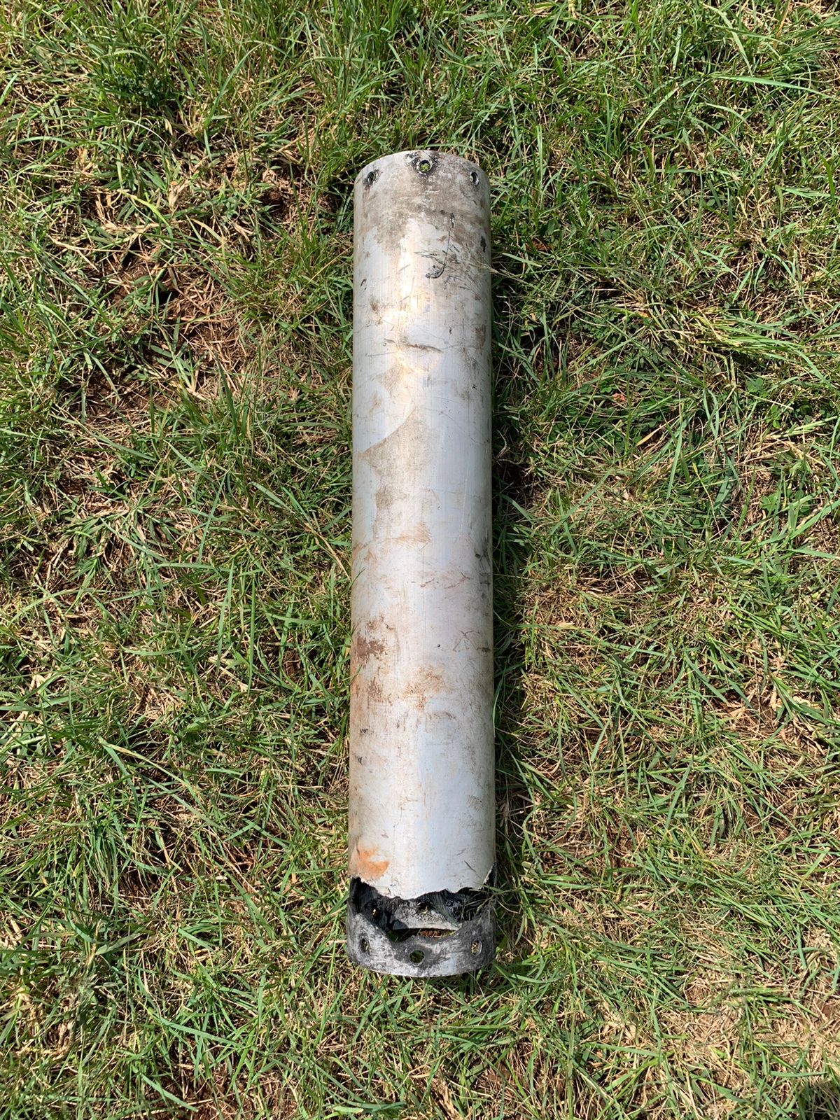
Static Test/Test #3/475f5efb-72d6-4bed-bb2a-de2ddac30baa.jpg
