nakujaproject/N-4_Solid_Propulsion/Static Test/Test #3/67685876-ea43-461c-90ff-0748b4c1349a.jpg

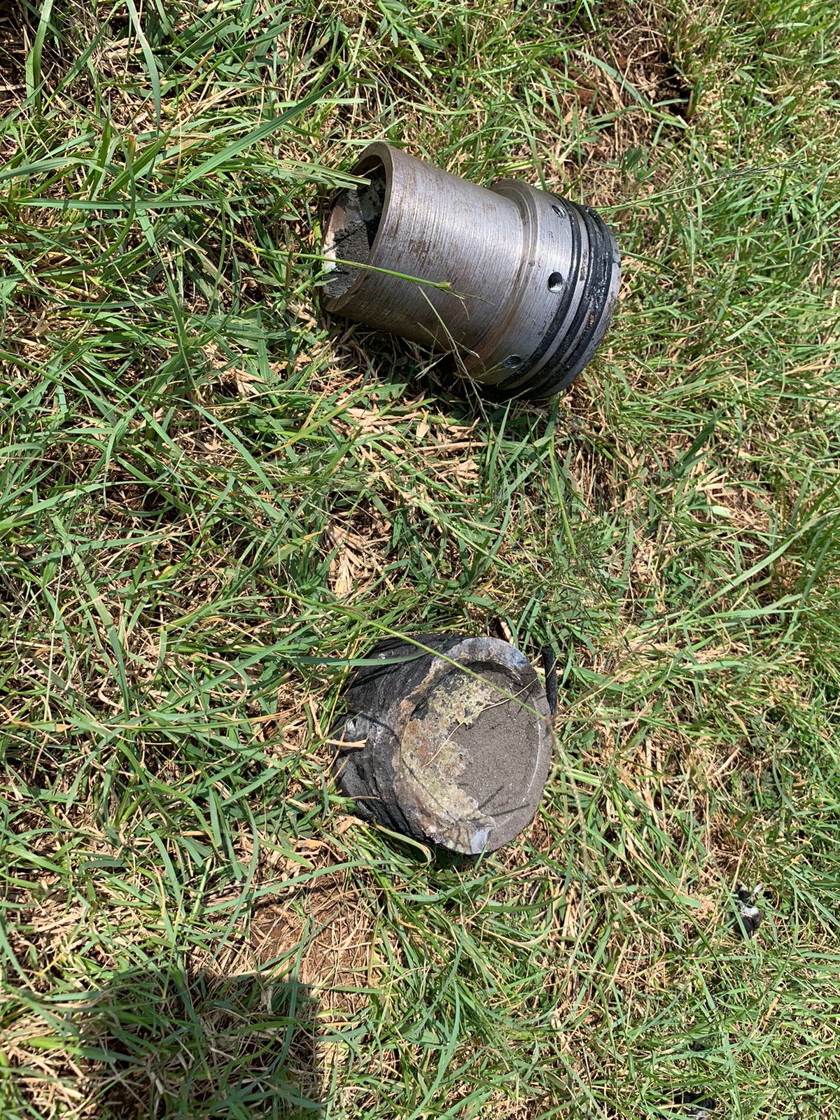
Static Test/Test #3/67685876-ea43-461c-90ff-0748b4c1349a.jpg
