nakujaproject/N-4_Solid_Propulsion/Static Test/Test #4/Screenshot 2024-10-31 212610.png

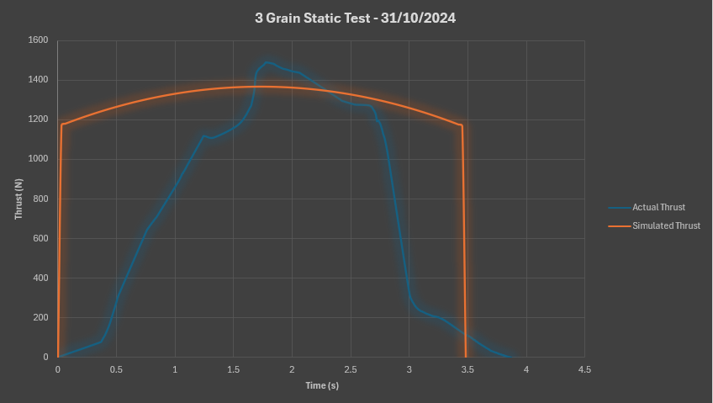
Static Test/Test #4/Screenshot 2024-10-31 212610.png
