nakujaproject/N-4_Solid_Propulsion/Static Test/Test #4/WhatsApp Image 2024-10-31 at 14.06.16.jpeg

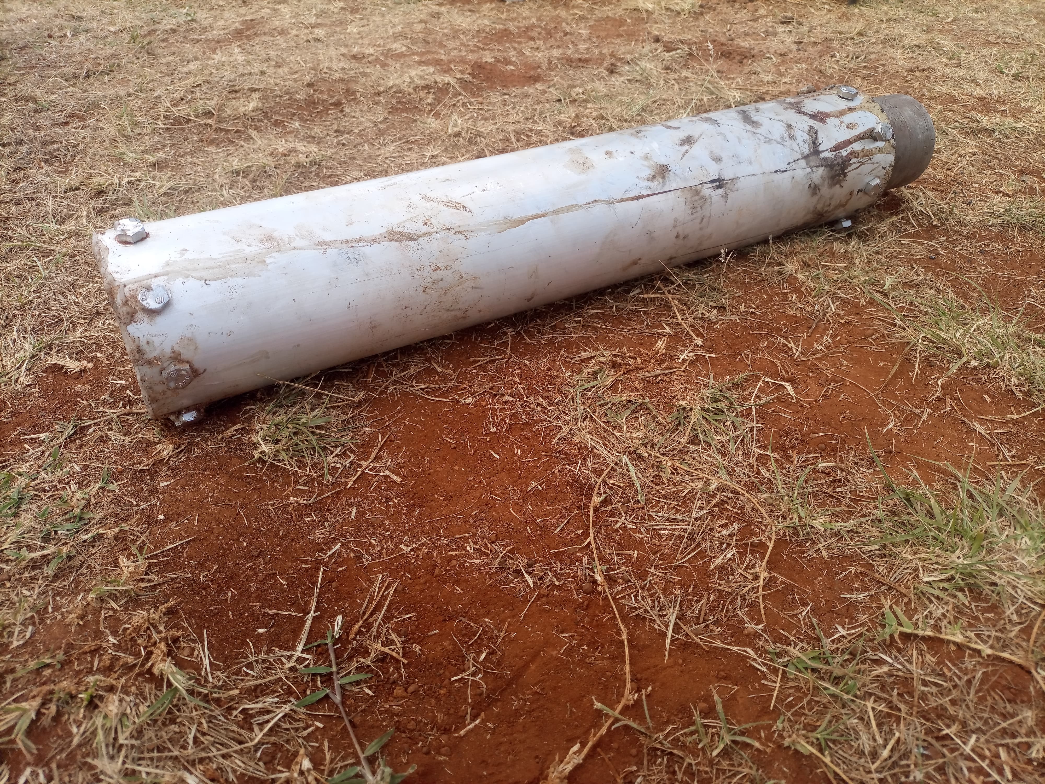
Static Test/Test #4/WhatsApp Image 2024-10-31 at 14.06.16.jpeg
