nakujaproject/N-4_Solid_Propulsion/(threads)

Thread 10 (2025-01-31):

Consideration of safer test stand site

shohei, 2025-01-31:

shohei, 2025-03-07:
- Visualize how to fix the stand to the ground
- Use soil hardner or cement?
- Cost estimation. Make a Bill Of Materials (BOM).
- Use of excavator. Does the farm have one?
- Confirmation of Location

NGGithua1, 2025-03-14:
updated design consideration
use of wooden beams, Ms plate t=1.5mm, Block boards (sw)
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

Closed 2025-03-14.

Thread 4 (2025-02-12):

Documentation of grain preparation

shohei, 2025-02-12:

Ogweno-lab, 2025-02-13:
[Static Test #5 Failure Analysis.pdf](https://github.com/user-attachments/files/18779976/Static.Test.5.Failure.Analysis.pdf)

azid0azide, 2025-02-19:
Here's the [link](https://github.com/nakujaproject/N-4_Solid_Propulsion/blob/main/Grains/Preparation/CookingKNSBTheRightWay.pdf) to the documentation.

azid0azide, 2025-02-19:
Here's the [link](https://github.com/nakujaproject/N-4_Solid_Propulsion/blob/main/Grains/Preparation/CookingKNSBTheRightWay.pdf) to the documentation. It should be noted that this isn't the final draft because of future optimization of the Grain Preparation Procedure.

Closed 2025-02-21.

Thread 8 (2025-02-21):

Preparation of the ignition circuit

shohei, 2025-02-21:
Repairing of the ignition circuit damaged at the last testing.

Thread 13 (2025-03-07):

Sorbitol mositure analysis

NGGithua1, 2025-03-07:
Test sample 1 results:
Initial moisture analysis shows a water content of 25.853%.

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

Test sample 2 in progress.

NGGithua1, 2025-03-14:
Test 2 results:

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

Test 3 results:

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

summary of results:
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

revised grain calculation, considering adjusted % of liquid sorbitol

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

[REVIEWED N4 GRAIN CALCULATION.docx](https://github.com/user-attachments/files/19245836/REVIEWED.N4.GRAIN.CALCULATION.docx)

shohei, 2025-03-14:
Could you talk to Mr. Matunda if we can have one more test? This is to confirm if the measurement for the sample #2 and #3 are more reliable.

azid0azide, 2025-03-14:
The following is the second draft of the report as we await the new single moisture content test: [link](https://github.com/nakujaproject/N-4_Solid_Propulsion/blob/main/Grains/Preparation/CookingKNSBTheRightWay.pdf)

Ogweno-lab, 2025-03-26:
### Misunderstandings in Data Interpretation
The collected data contain a slight misunderstanding that, when taken into account, ought to make the analysis more coherent.

## 1. Test One
In the first test, the experimental H20 percentage presented is not the percentage of H20 evolved from the sorbitol alone. It gives the percentage as a fraction of the total initial mass (which includes the mass of the dish, w0). When corrected in the calculation, the actual initial mass of sorbitol is **17.29g**, and the mass of moisture evolved is **4.45965g**. This gives an experimental value of **25.79%**:
_Actual mass of sorbitol (initial)_ = 22.87g - 5.58g = **17.29g**
_Mass of moisture evolved_ = 0.195*22.87 = **4.45965**
_Moisture Percentage (actual)_ = (4.45965/17.29)*100 = **25.79%**

## 2. Tests 2 & 3
In these tests, the analyzer was tared after the placement of the dish, and hence, _W0 ought to be zero._ When this is taken into account, experimental and theoretical values match more closely.

## Actual Table of Results
| W0 |W1  |W2  |%H20 Experimental|%H20 Theoretical|
|------|-------|--------|----------------------|-------------------|
|5.58g|22.87g|18.40g|25.79|25.85|
|0g     |18.99g|14.00g|26.30|26.27|
|0g     |19.01g|13.90g|26.85|26.88|
|------|-------|**Average**|**26.31**|**26.33**|

## Recommendations for later Tests
For any test conducted afterward, I recommend taring the analyzer just after placing the dish to remove it from the calculations. This makes it easier to compare percentages from the analyzer and hand calculations.

azid0azide, 2025-04-19:
## On the issue of `W0`...

This issue was brought by the fact of a misunderstanding and we finally agreed, after research and deliberation, that W0 is not necessary in this experiment. This is refleected on the updated Grain Preparation write  up, [here](https://github.com/nakujaproject/N-4_Solid_Propulsion/blob/main/Grains/Preparation/CookingKNSBTheRightWay.pdf).

## On the inconsistent value of Test 1...
We found it fit to discard it in the updated document and a new table of values as below was obtained:

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

Thread 9 (2025-03-07):

Mandrel Purchase and Fabrication

NGGithua1, 2025-03-07:
Mandrel wood already purchased.
Assistance required accessing wood lathe from capentry workshop for machining.

shohei, 2025-03-28:
Mandrel fabrication requires interventio. Will talk to the workshop manager for the assistance.

Ogweno-lab, 2025-04-04:
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

We were able to setup the mandrel on the lathe with the help of the manager. The belt however needs replacement and he has made an order. He asked to come back on Monday; Mr. Mwai will help up with the machining

Thread 22 (2025-08-01):

Cutting of Casing

azid0azide, 2025-08-01:
## Why this is important

These casings are in preparation for the 1 grain pressure test. Originally some were warped and couldn't be used. These will help confirm whether importation of Aluminium 6061 T6 will be necessary and help us get the values of $a$ and $n$ for determining [burn rate](https://github.com/nakujaproject/internship2025/tree/main/solid_propulsion/Burn_Rate_Experiment) and chamber pressure.
