nakujaproject/N-4_Solid_Propulsion/SRM Components/Bulkhead_Drawing.pdf

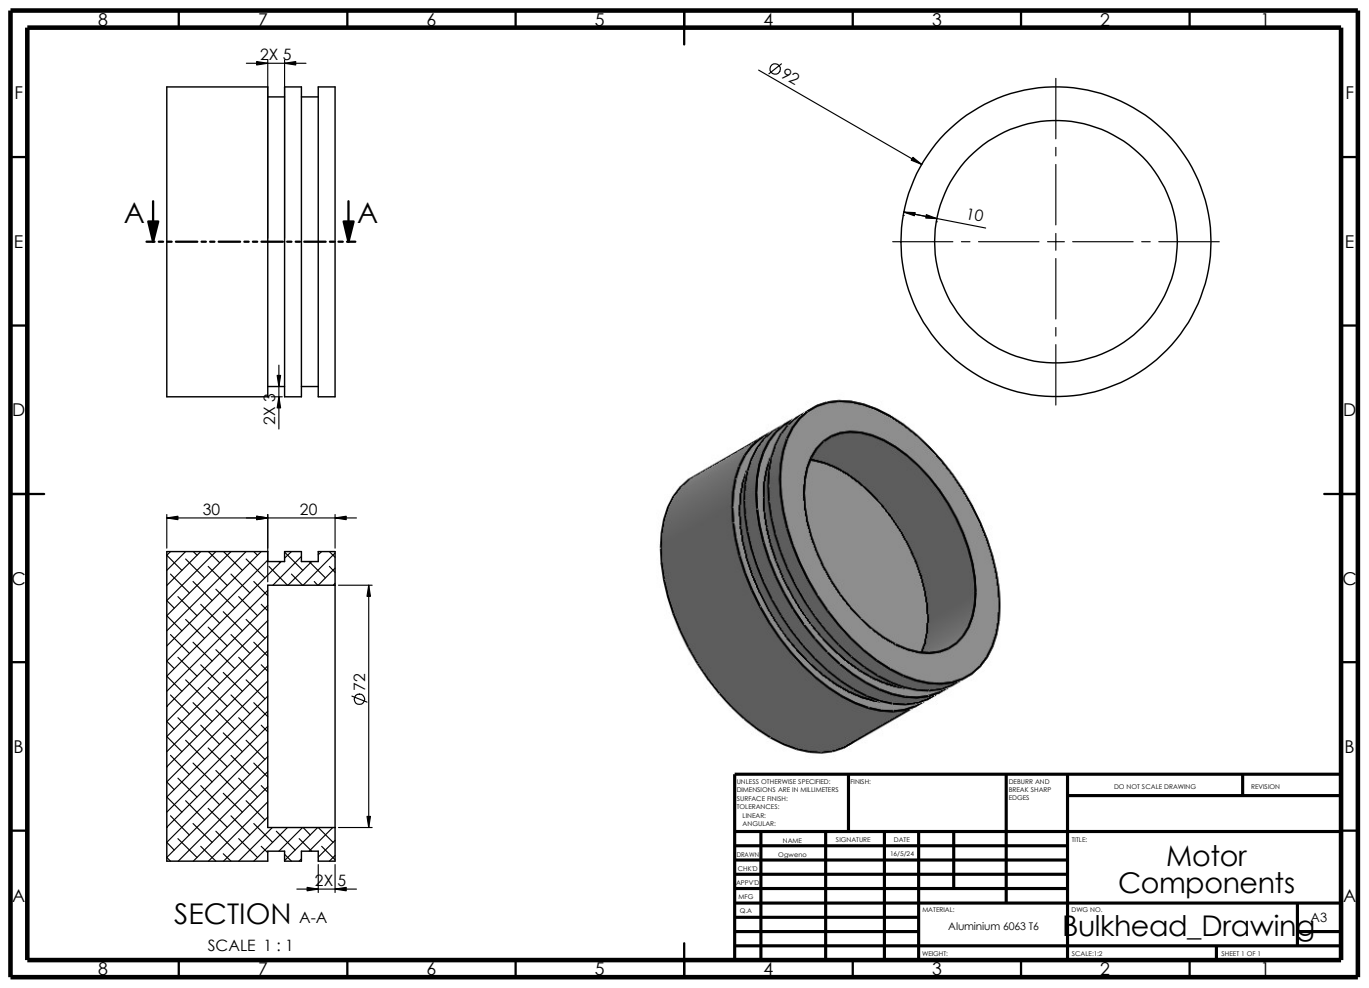
[picture p52: page 1]
CHK'D; WEIGHT:; SHEET 1 OF 1; SCALE:1:2; FINISH:; EDGES; DO NOT SCALE DRAWING; REVISION; BREAK SHARP; DEBURR AND; SECTION A-A; SCALE 1 : 1

UNLESS OTHERWISE SPECIFIED:
DIMENSIONS ARE IN MILLIMETERS
SURFACE FINISH:
TOLERANCES:
LINEAR:
ANGULAR:

DRAWN | Ogweno | | 16/5/24
Q.A | MATERIAL: Bulkhead_Drawing Aluminium 6063 T6 | DWG NO. | A3

NAME | SIGNATURE | DATE | TITLE: Motor Components

APPV'D
MFG
