nakujaproject/N-4_Solid_Propulsion/SRM Components/Nozzle2_Drawing_redesigned.PDF

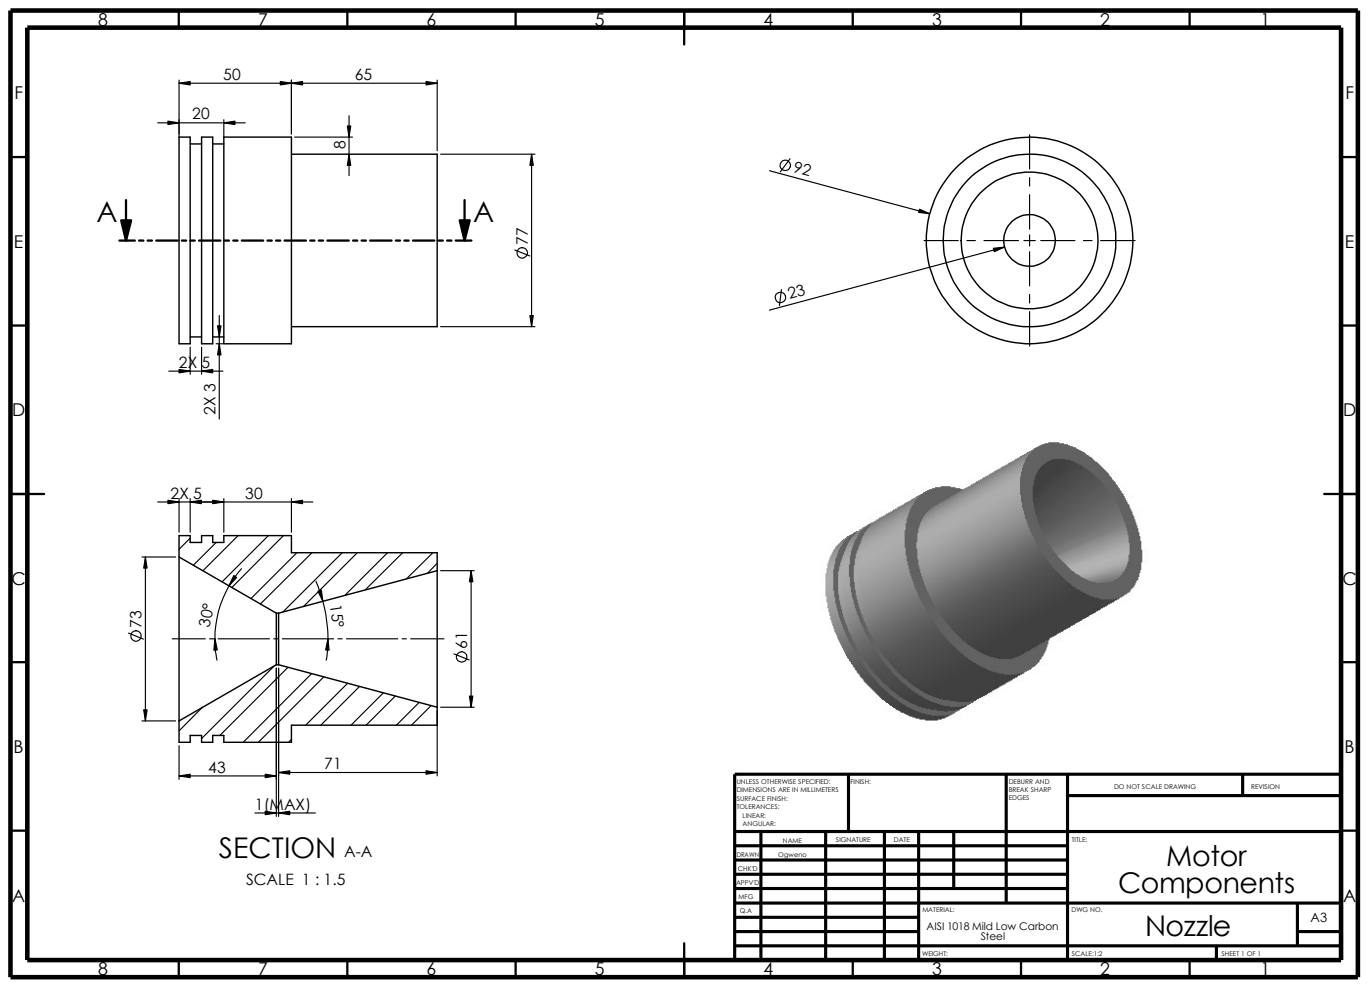
[picture p53: page 1]
DO NOT SCALE DRAWING; REVISION; SCALE:1:2; BREAK SHARP; WEIGHT:; FINISH:; EDGES; SHEET 1 OF 1; DEBURR AND; SECTION A-A; SCALE 1 : 1.5 ⁷³; 1(MAX)

UNLESS OTHERWISE SPECIFIED:
DIMENSIONS ARE IN MILLIMETERS
SURFACE FINISH:
TOLERANCES:
LINEAR:
ANGULAR:

CHK'D | | | | | | | DWG NO. DRAWN

NAME | SIGNATURE | DATE | | | | TITLE: Motor Components
Ogweno

APPV'D
MFG
Q.A | | | | MATERIAL: Steel AISI 1018 Mild Low Carbon | Nozzle | A3
