nakujaproject/N-4_Solid_Propulsion/Ignition System/Trigger Module/Schematic_Trigger-Module-Rocket-Launcher-V2-dual_2025-02-07.pdf

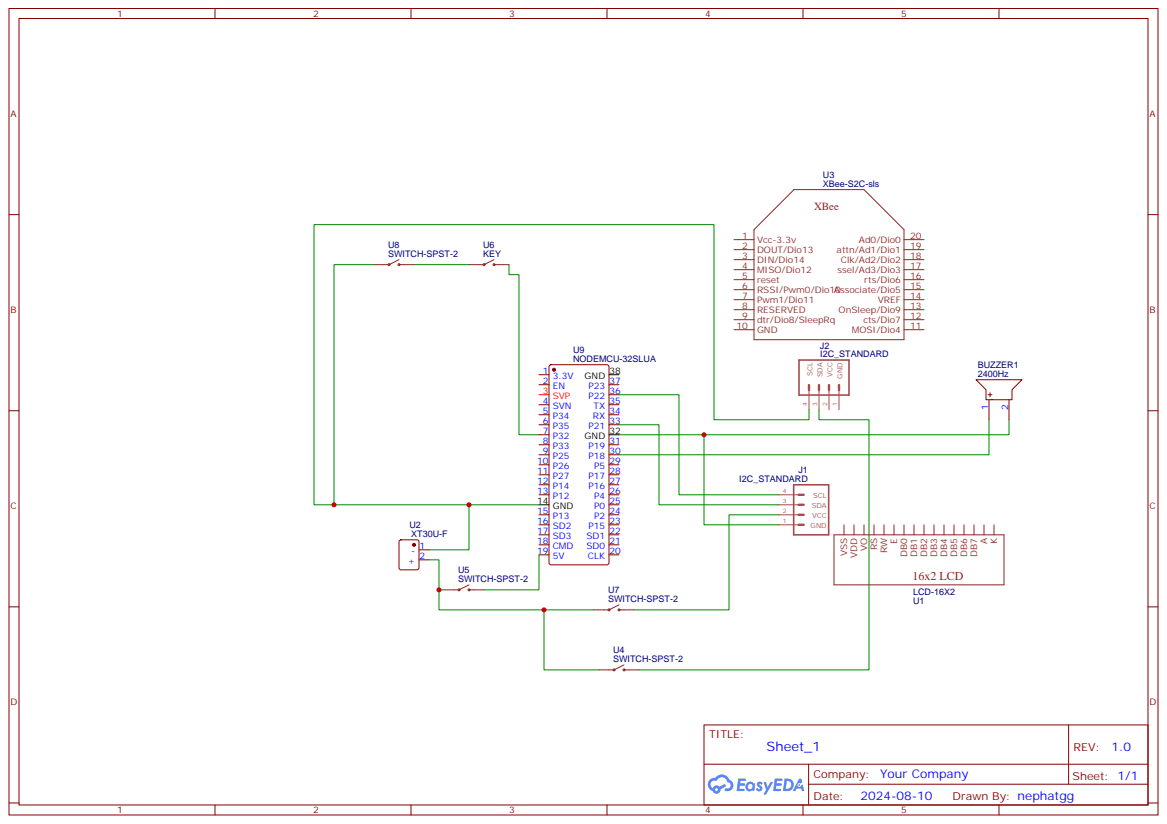
[picture p54: page 1]
