nakujaproject/N-4_Solid_Propulsion/Ignition System/Power Distribution Board module/Schematic_LM2596HVS-Power-Distribution-board-initiator_2025-02-07.pdf

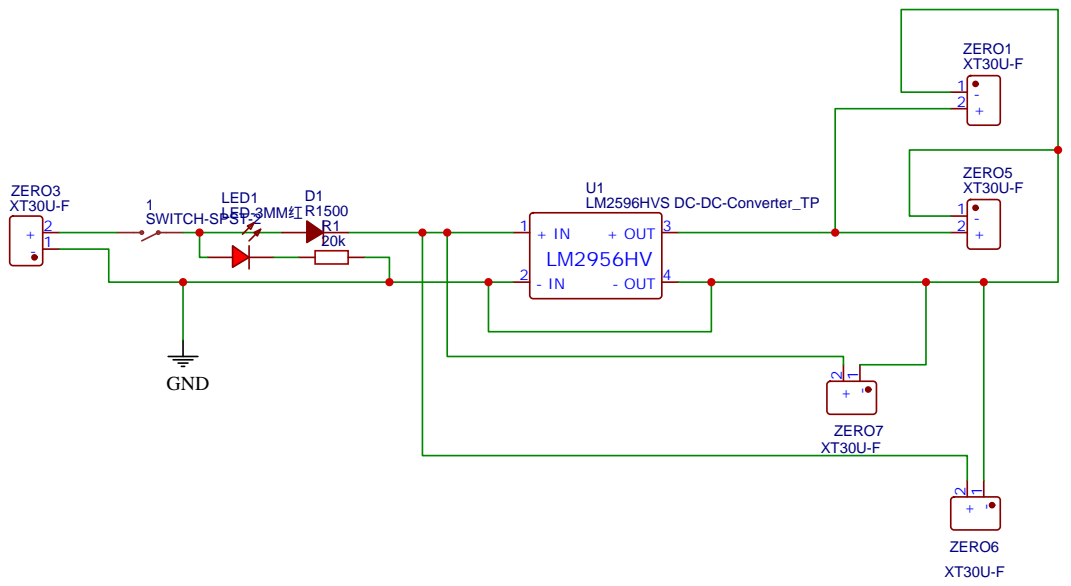
[picture p55: page 1]
