nakujaproject/N-4_Solid_Propulsion/Ignition System/Igniter circuit module/Schematic_Rocket-launcher-V2-dual_2025-02-07.pdf

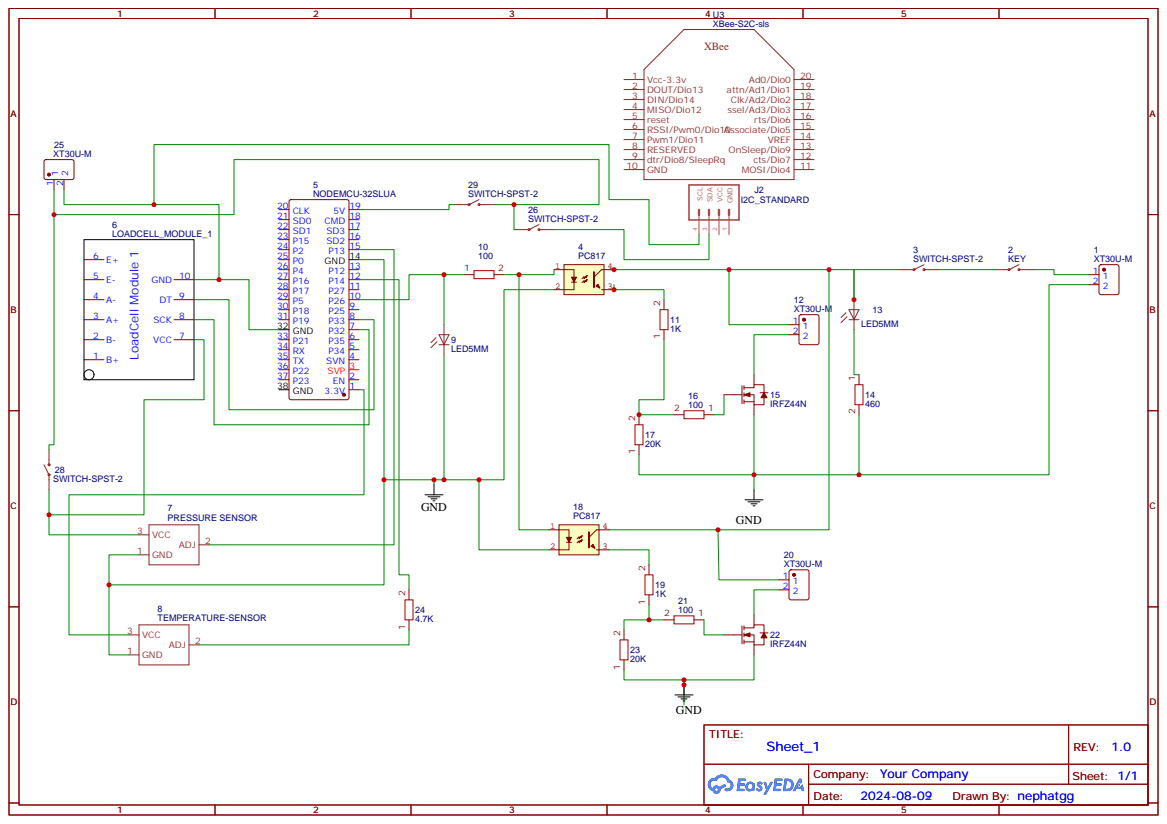
[picture p56: page 1]
