nakujaproject/N-4_Solid_Propulsion/Ignition System/Alarm system module/Schematic_Sound-Generator-Module-FY-Project_2025-02-07.pdf

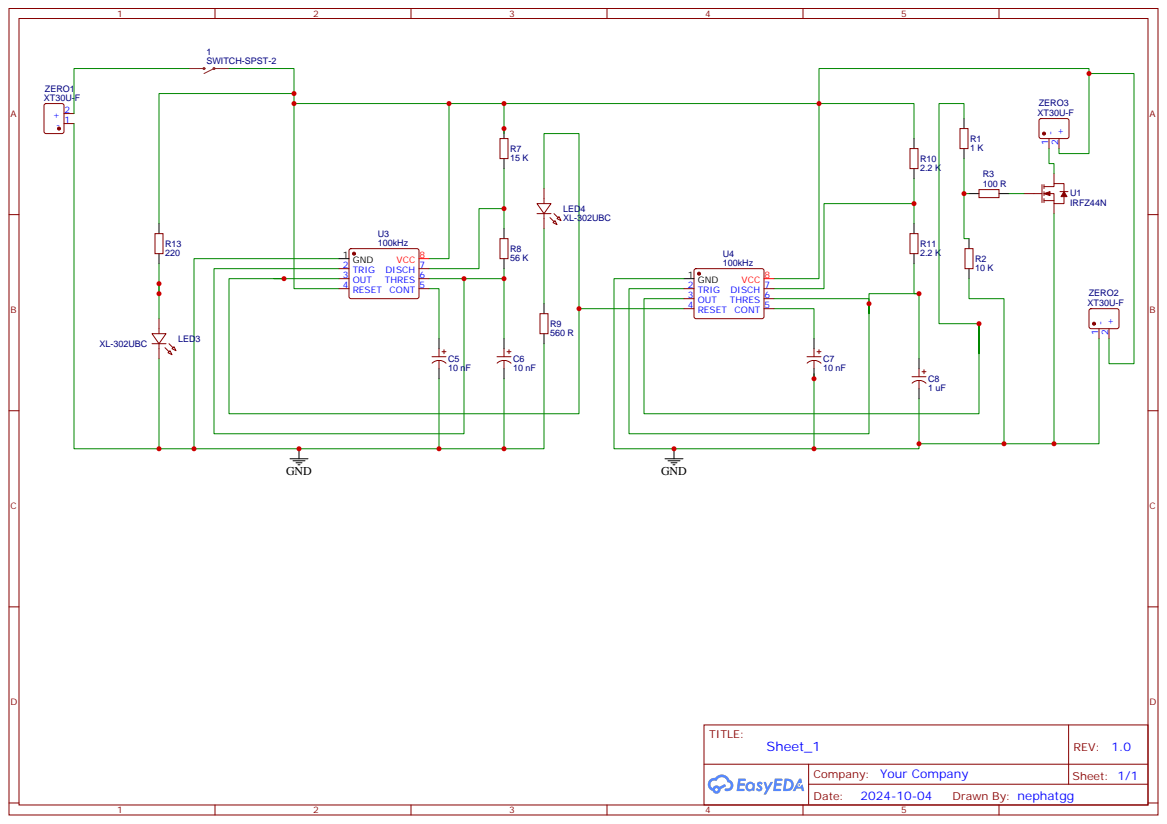
[picture p57: page 1]
