nakujaproject/N-4_Solid_Propulsion/Ignition System/Trigger Module/PCB_PCB_Trigger-Module-Rocket-Launcher-V2-dual_2025-02-07.pdf

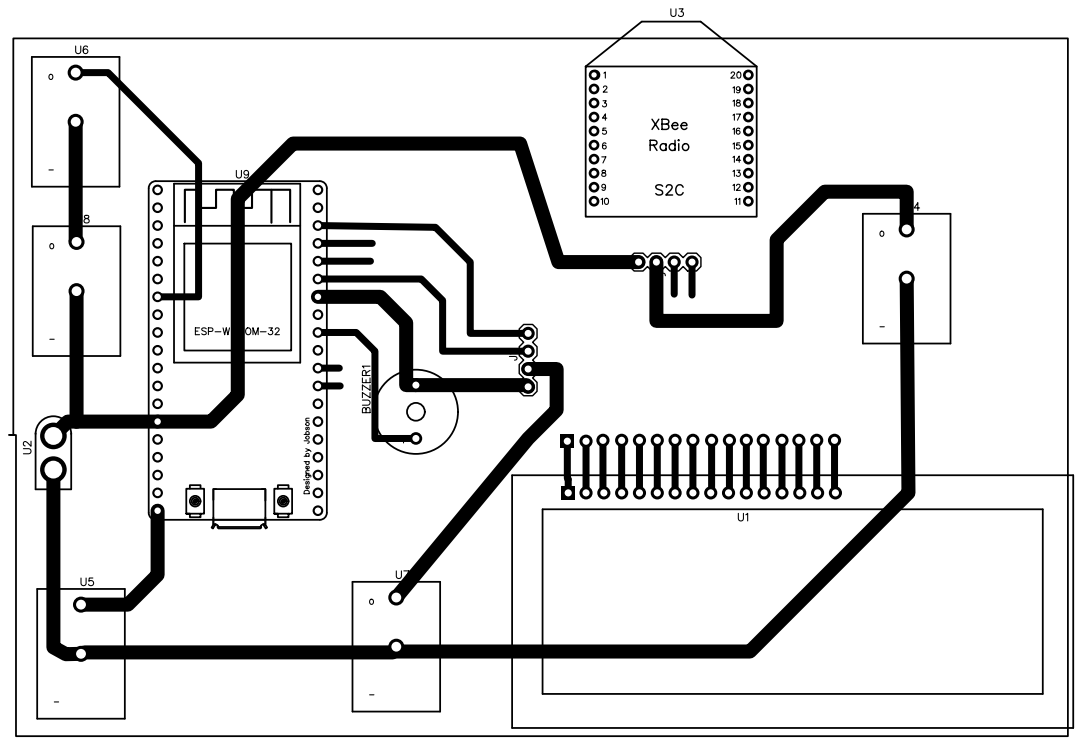
[picture p58: page 1]
