nakujaproject/N-4_Solid_Propulsion/Ignition System/Power Distribution Board module/PCB_PCB_LM2596HVS-Power-Distribution-board-initiator_2025-02-07.pdf

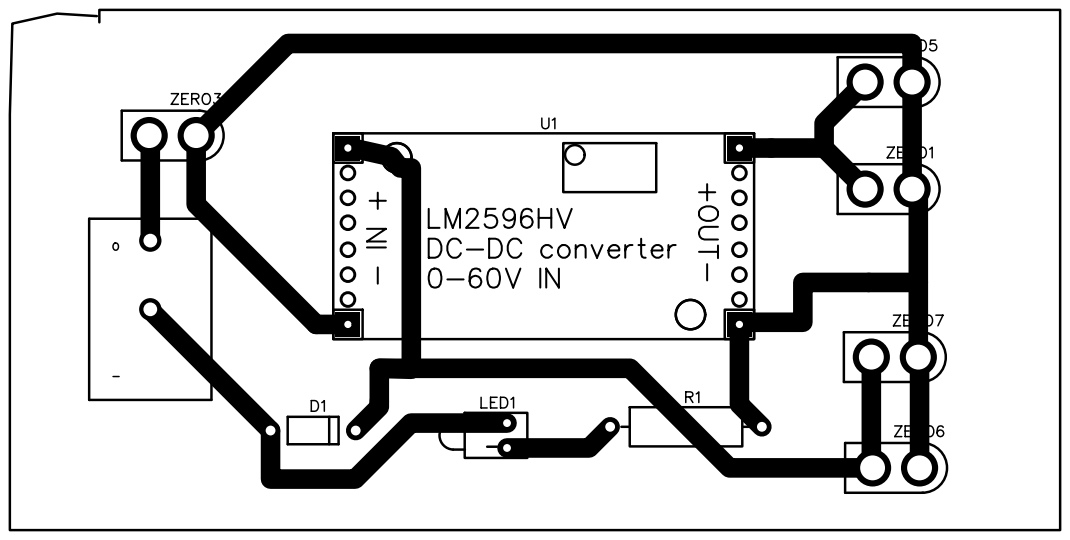
[picture p59: page 1]
