nakujaproject/N-4_Solid_Propulsion/Ignition System/Igniter circuit module/gerber final.pdf

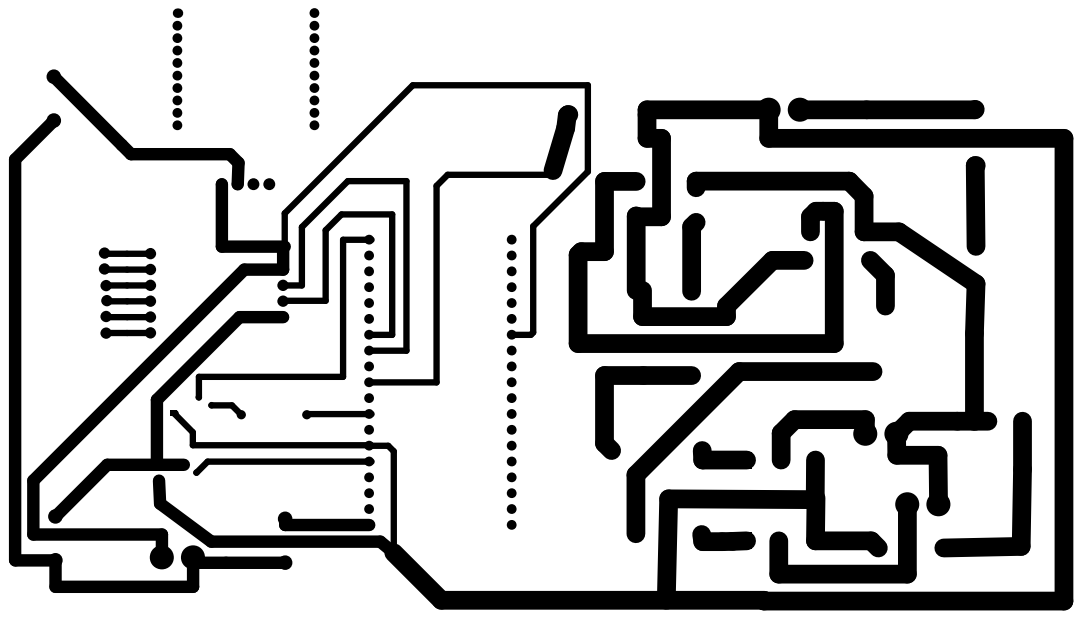
[picture p60: page 1]
