nakujaproject/N-4_Solid_Propulsion/Ignition System/Alarm system module/PCB_PCB_Sound-Generator-Module-FY-Project_2025-02-07.pdf

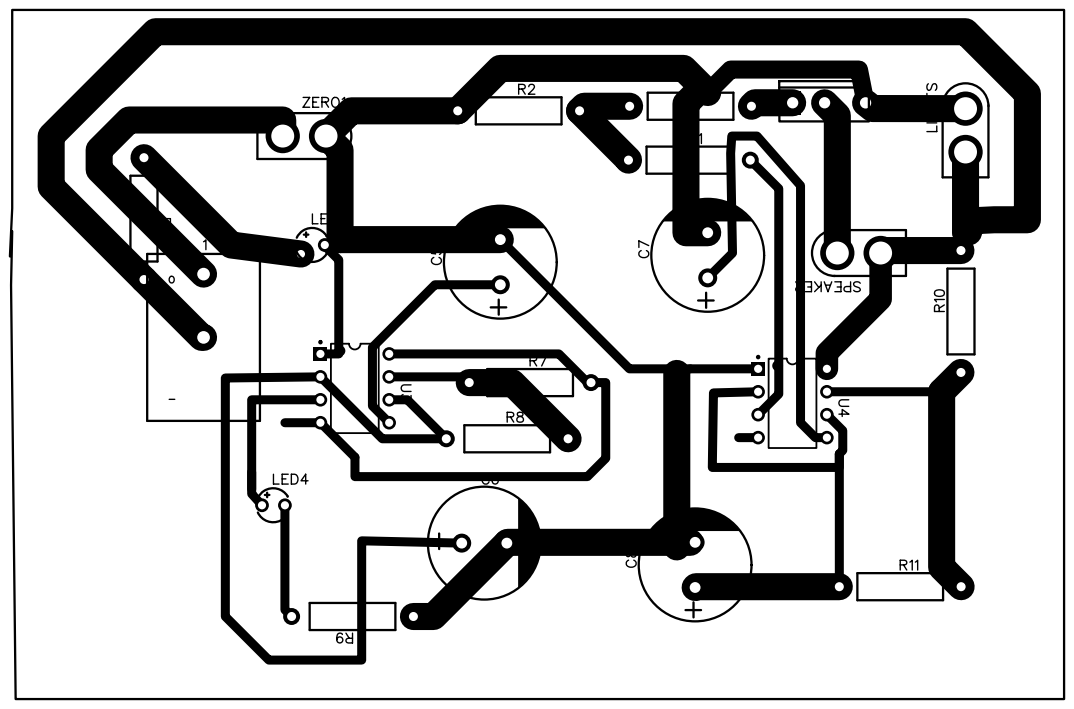
[picture p62: page 1]
