nakujaproject/N-4_Solid_Propulsion/(commit log)

2025-02-06 chore(Propellant Evaluation #74): PEP files
    This contains the analysis files. Worry not. This isn't the final draft. We're yet to carry out tests on a sample of the KNSB and the potential suppressants and catalysts required for this to work
2025-02-07 Added motor CAD files
    [Assem1.SLDASM, BodyTubeJig 1X15mm.SLDPRT, Bulkhead.SLDPRT, Bulkhead_Drawing.SLDDRW, Casing.SLDPRT, Casing_drawings.SLDDRW, Nozzle2.SLDPRT, Nozzle2_Drawing.SLDDRW]
2025-02-07 Added Test Stand CAD files
    [TestStand_Design#2.SLDASM, TestStand_Design#2.STEP]
2025-02-07 Added Files for Static Test #1
    [Bulkhead.SLDPRT, Casing_Test#1.SLDPRT, Motor_Assembly_Test#1.SLDASM, N4_1grain_simulated.csv, Nozzle2.SLDPRT, StaticTest1.xlsx]
2025-02-07 Added Files for Static Test #2
    [Simulated.csv, Static test II 26-07-24.csv, Test Data Analysis.xlsx]
2025-02-07 Added Files for static test #3
    [3_grain_Casing.SLDPRT, 3_grain_Motor.SLDASM, Bulkhead.SLDPRT, Nozzle2.SLDPRT, Simulated.csv, static test 13th aug 2024.csv]
2025-02-07 Added files for static test #4
    [3_grain_Casing.SLDPRT, 3_grain_Motor.SLDASM, Bulkhead.SLDPRT, Nozzle2.SLDPRT, Simulated.csv, Static test 25th april 2024 analysis..xlsx, Static test on 31st Oct 2024 (Analysis).csv, Static test on 31st Oct 2024 (Analysis).xlsx]
2025-02-07 fix(SMS): dodged that one!
    I had almost ruined the whole repo by not asking what SRM stands for! SRM is Solid Rocket Motor. Obviously!
    Assigned-to: @azid0azide
2025-02-07 minor: corrected my errors
    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
    [Assem1.SLDASM, BodyTubeJig 1X15mm.SLDPRT, Bulkhead.SLDPRT, Bulkhead_Drawing.SLDDRW, Casing.SLDPRT, Casing_drawings.SLDDRW, Nozzle2.SLDPRT, Nozzle2_Drawing.SLDDRW]
2025-02-10 chore(Propellant Evaluation #74): add results of ProPEP simulations
    This will help before we go into analysing the Propellant.
    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
2025-02-11 chore(Decatalysis): add ProPEP screenshots
    These are yet to have the graphs attached to them. Also, I need to change the Safety manual from a simple .md file to an actual downloadable file.
    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
